OdaijinSamaX/wildlife-cam/hardware/enclosure/README.md

# enclosure-lab

屋外 IoT の防水筐体を **AI が設計して 3D プリントする** ための作業台。

AI が CAD を扱うときの本質的な弱点は「目が無い」ことにある。だからこのリポジトリの
本体は CadQuery のラッパではなく、**書いた形を自動で見て・測って・数字で突き返す
ループ**である。

```
設計スクリプト (CadQuery)
   -> build   : STEP / STL / 3MF
   -> render  : 6 面 + iso + 断面 PNG（人と AI が目で見る用）
   -> checks  : 肉厚・密閉・干渉・サイズ枠・オーバーハング・開口を数値で判定
   -> report  : out/<design>/report.md に画像と数値と PASS/FAIL
```

最初の利用先は wildlife-cam（Pi Zero 2 W のトレイルカメラ）。プリンタは
**Bambu Lab P1S**（密閉筐体・ASA 可）、造形枠 256 x 256 x 256 mm。

## 1 行で試す

```bash
uv run python -m harness check designs/wildlife_cam/fit_coupon.py
```

`out/fit_coupon/` に STEP / STL / 3MF と PNG 9 枚と `report.md` が出る。

```bash
uv run python -m harness check designs/wildlife_cam/pir_bezel.py
uv run python -m harness list                 # 設計とチェックの一覧
uv run pytest                                 # ネガティブテスト（下記）
```

主なオプション:

| オプション | 意味 |
|---|---|
| `--only wall,openings` | 一部のチェックだけ走らせる |
| `--no-render` | PNG を作らない（速い） |
| `--no-export` | STEP/STL/3MF を作らない |
| `--pitch 0.4` | openings のボクセルピッチを上書き |
| `--out DIR` | 出力先を変える |

終了コードは総合判定が FAIL のとき 1、それ以外 0。CI に直接掛けられる。

## 環境構築

```bash
curl -LsSf https://astral.sh/uv/install.sh | sh   # uv が無ければ
uv sync                                            # .venv を作って依存を入れる
```

`sudo` も apt も要らない。すべて PyPI の wheel で完結する。

### なぜ Python 3.12 なのか

母艦のシステム Python は 3.14 だが、**CadQuery / OCP には 3.14 用の wheel が無い**。
`.python-version` で 3.12 に固定し、`uv` がプロジェクト専用の Python を持ってくる。
システム Python には一切触らない。実績のある組み合わせは:

| | バージョン | 備考 |
|---|---|---|
| Python | 3.12.13 | uv が管理。3.14 では OCP が入らない |
| cadquery | 2.8.0 | |
| cadquery-ocp | 7.9.3.1.1 | OCCT 7.9 |
| vtk | 9.6.2 | レンダに使う |
| trimesh | 5.0.0 | メッシュ側のチェックに使う |
| shapely | 2.1.2 | 断面ラスタライズと張り出し幅の計算 |

### ヘッドレスレンダについて

GUI が無いのでオフスクリーン描画が要る。実際に試した結果:

- **採用: VTK のオフスクリーン (EGL)** — `vtkRenderWindow.SetOffScreenRendering(1)`
  だけで PNG が出た。VTK は X への接続に失敗したあと EGL に落ちる
  （`bad X server connection. DISPLAY=` という警告が出るが無害）。
  apt パッケージも仮想ディスプレイも要らない。
- **予備: numpy の Z バッファによるソフトウェアラスタライザ** —
  `harness/render.py` に同梱。EGL が使えない環境や GPU の無いコンテナ用。
  `ENCL_RENDERER=soft` で強制でき、VTK が例外を投げたときも自動で切り替わる。
- **却下: `xvfb-run`** — apt が必要（この母艦では sudo パスワードが要る）。
- **却下: pyrender / OSMesa ホイール** — 依存が重く、VTK で足りたので採用しなかった。

レンダが真っ白/真っ黒になった場合は VTK 側の失敗とみなして自動でソフトウェアに
落ちる。どちらを使ったかは `report.md` の先頭に出る。

## リポジトリの中身

```
harness/           ハーネス本体
  cli.py           `python -m harness check <design.py>`
  design.py        設計スクリプトの読み込みと派生データのキャッシュ
  geom.py          B-rep <-> メッシュ <-> ボクセルの変換（OCC / trimesh / shapely はここだけ）
  build.py         STEP / STL / 3MF 出力
  render.py        多視点 + 断面 PNG（VTK / ソフトウェア）
  report.py        Markdown レポート
  component.py     内蔵部品を表す型
  feature.py       フィーチャの占有領域 (claim) を表す型と、その作り方
  fit.py           寸法補正テーブル（実測から起こした造形の癖の吸収）
  seal.py          パッキンの面圧（蓋を梁・パッキンを非線形の弾性床として解く）
  captive.py       捕捉式ねじが成立するための寸法の連鎖
  underside.py     基板の下に出ている実装部品と受け面の隙間
  checks/          13 のチェック（下記）
parts/             内蔵部品のダミー形状（BOM プリミティブ）
designs/           設計スクリプト
tests/             ネガティブテスト
out/               生成物（.gitignore 済み）
docs/AGENTS.md     AI が設計を書くときの規約
docs/HARNESS.md    各チェックの意味・閾値の根拠
docs/DECISIONS.md  設計判断の記録（不採用にした案も残す）
docs/layout-study.md  wildlife-cam 内部レイアウトの比較検討（4 案 + 推奨）
docs/window-options.md  カメラ窓の方式と材料の比較
docs/field-procedure.md 現地作業手順の下書き
docs/enclosure-body.md  カメラユニット本体の設計判断（貫通・締結・分割の是非）・限界
docs/lid-fastening.md   蓋の締結点の数と位置。パッキンの面圧をたわみから解いた記録
docs/captive-fasteners.md  蝶ねじを蓋に残す（落としたら二度と見つからない）
docs/pcb-tray.md        基板トレー。CSI レスキューを付けた Pi と x の収支 0.4 mm
```

## チェック

| # | 名前 | 見るもの |
|---|---|---|
| 0 | fit | 寸法補正テーブルの素性と、どの寸法にいくら足したかの記録 |
| 1 | manifold | 水密・多様体か（B-rep とメッシュの両方） |
| 2 | wall | 最小肉厚（レイキャスト法）。薄い箇所は座標も出す |
| 3 | bbox | 造形姿勢を適用したあと P1S の枠に収まるか |
| 4 | interference | ソリッド同士のブーリアン積の体積が 0 か |
| 5 | layout | **同じソリッドの中で**フィーチャ同士が場所を奪い合っていないか |
| 6 | clearance | 内蔵部品の外形 + クリアランスが筐体と干渉しないか |
| 7 | overhang | 造形姿勢を適用したあとの下向き面の面積と渡り幅 |
| 8 | openings | 内外を貫通する開口の一覧と面積（防水の要） |
| 9 | fov | カメラの視野を筐体が遮っていないか |
| 10 | seal | 締結点の間でパッキンの潰し量が保つか（蓋を梁、パッキンを弾性床として解く） |
| 11 | captive | 捕捉式ねじが「落ちない・抜けきる・平らに座る」か（形にレイを飛ばして実測） |
| 12 | underside | 基板の**下**に出ている実装部品が受け面に当たらないか（同じく形から実測） |

**すべてのチェックは PASS/FAIL だけでなく実測値を返す。**
閾値の根拠と「何を見逃すか」は `docs/HARNESS.md` にある。

## ネガティブテストという約束

このリポジトリの最大の失敗モードは **「チェックが常に PASS を返すだけの飾りに
なること」**。それを防ぐため、各チェックには「意図的に壊した設計を食わせると
FAIL する」テストが付いている。

```bash
uv run pytest -q
```

- 肉厚を 0.8 mm に落とした変種 → `wall` が FAIL
- 部品を壁にめり込ませた変種 → `clearance` が FAIL
- 300 mm に伸ばした変種 → `bbox` が FAIL
- 止まり穴を貫通させた変種 → `openings` がその穴を検出して FAIL
- 造形姿勢を 90 度倒した変種 → `overhang` が FAIL
- O リング溝を基準ピンの根元に重ねた変種 → `layout` が FAIL（実際に出た不具合の再現）
- 取付ねじをシール溝に寄せた変種 → `layout` が FAIL
- 穴の宣言を 1 つ落とした変種 → `layout` が「宣言し忘れ」として FAIL
- 蓋の締結点を四隅 4 点に戻した変種 → `seal` が FAIL（実際に出た指摘の再現）
- トレーの座面を縮めた変種 → `underside` が FAIL（基板の裏のナットが当たる）

**ネガティブテストが無いチェックは未完成とみなす。**

## いまある設計

| 設計 | 何のためか |
|---|---|
| `designs/wildlife_cam/fit_coupon.py` | 公差校正クーポン v1。**2026-08-22 に印刷して実測済み**の実物の記録（凍結） |
| `designs/wildlife_cam/fit_coupon_v2.py` | 同 v2。補正テーブルを通し、基準ピンを折り取り式の独立部品にした。実測値と導出は [fit_coupon.md](designs/wildlife_cam/fit_coupon.md) |
| `designs/wildlife_cam/pir_bezel.py` | HC-SR501 を筐体壁に防水で貫通させる接着封止キャリア |
| `designs/wildlife_cam/layout_study_{a,b,c,d}.py` | 内部レイアウトの比較検討 4 案。結論は [layout-study.md](docs/layout-study.md) |
| `designs/wildlife_cam/camera_unit.py` | **カメラユニット本体（実設計）**。案D を起こしたもの |
| `designs/wildlife_cam/camera_unit_lid.py` | 同 背面の蓋。鞍（V 溝）とベルト溝つき |
| `designs/wildlife_cam/window_snoot.py` | カメラ窓（主案）。既製ドーム蓋 + カメラ送り出し筒 |
| `designs/wildlife_cam/window_hood.py` | カメラ窓（代替案）。平板 + 庇 |

どちらも **まだ印刷していない**。

`pir_bezel.py` は名前こそベゼルだが、中身は**接着封止キャリア**である。
HC-SR501 の実測（2026-08-22）でドームにツバが無いことが判明し、
「フランジを O リングで壁に押し付ける」旧構成が不成立になったため作り直した。
検討して不採用にした案を含む経緯は [docs/DECISIONS.md](docs/DECISIONS.md) にある。

筐体本体の設計に入る前に、`docs/AGENTS.md` の「内蔵部品の寸法順位」を見ること。
最長の部品は SORACOM Onyx（USB ドングル・95 mm）で、筐体の内寸はこれで決まる。
