OdaijinSamaX/wildlife-cam/hardware/enclosure/.ai/HANDOFF.md

# HANDOFF — 筐体設計（`hardware/enclosure/`）

- 最終更新: 2026-08-23（**レスキュー装着後の Pi に合わせて箱ごと引き直した**）
- **この文書は、会話の記憶が無いエージェントが最初に読むもの。**

---

## 0. 読む順序

1. **`docs/AGENTS.md`** — このリポジトリで設計するときの規約。
   とくに §3.5（寸法補正テーブル）・§4.5（フィーチャの占有領域）・
   **§4.9（現地で保守する人のための設計原則）** は全設計に効く。
2. **`docs/DECISIONS.md`** — これまでの決定事項（D-001 〜 **D-023**）。
   **不採用にした案も理由つきで残してある。** 同じ検討を二度やらないため。
3. **`docs/HARNESS.md`** — チェック **13 種**の意味・閾値の根拠・**何を見逃すか**。
4. 個別の経緯が要るときだけ:
   `docs/layout-study.md` / `docs/window-options.md` / `docs/enclosure-body.md` /
   `docs/lid-fastening.md` / `docs/captive-fasteners.md` /
   **`docs/pcb-tray.md`（基板トレー。x の収支が 0.4 mm しか無い理由）** /
   `docs/field-procedure.md`
5. **各設計ファイルの docstring。** 何のための部品か・未確定事項が先頭に書いてある。

---

## 1. どこまで到達したか

**2026-08-23 に「レスキュー装着後の Pi の実測」が入り、箱の外形から引き直した。**
全チェック PASS/WARN（FAIL・ERROR なし）、テスト 210 件通過。

| 設計 | 状態 |
|---|---|
| `camera_unit.py` | **本体。外形 84 -> 88（D-022）。** トレーの受けも作り直した（D-023） |
| `camera_unit_lid.py` | **背面の蓋。** パッキン経路を本体から導出。**`seal` は 21.0% -> 21.2%** |
| **`pcb_tray.py`** | **全面書き直し。** レスキュー装着後の Pi を 2 本 + ナットポケットで保持 |
| `window_snoot.py` | カメラ窓（主案）。**ドームの 7 項目が未実測なので刷れない** |
| `window_hood.py` | カメラ窓（代替）。平板 + 庇 |
| `pir_bezel.py` | PIR 接着封止キャリア |
| `fit_coupon.py` / `_v2.py` | 公差校正クーポン（v1 は印刷実物の記録として凍結） |
| `layout_study_{a,b,c,d}.py` | レイアウト比較検討。**採用は案D** |

外形は **88 x 50 x 198 mm**（造形時の Z は 50 mm。§6 の注意を読むこと）。

### 2026-08-23: 箱を 84 -> 88 にした（D-022）

Pi には **CSI コネクタのラッチが壊れた個体を救うためのレスキューブラケット**
（双葉数理技術「Camera Connector Rescue」）が付いている。**Pi の外形そのものが変わる。**

**束縛していたのは「内寸 78.0」ではなく「背面の開口 74.0」だった。**
microSD を挿したままの剛体幅は **76.9 mm**（4.1 + 65.0 + 7.8。全部実測）で、
**開口 74.0 に 2.9 mm 足りない。** `rim_step` を下限 1.35 まで削っても 1.6 mm 足りず、
**幅を増やすしかなかった。** 増やした片側 2 mm は全部内側へ回してある。

**`seal` の最小圧縮率は 21.0% -> 21.2% で、落ちていない**（蓋が広くなって
断面二次モーメントが増えたぶんが、パッキン経路が伸びたぶんを上回った）。
D-019（締結 6 点）の結論は維持される。

### 2026-08-23: トレーを作り直した（D-023）

- **ブラケットが CSI 側の取付穴 2 個をねじ + ナットで占有**していた（写真で確認）。
  **共締めは不成立。** microSD 側の 2 本 + **ナットポケット 2 個**で保持する
- **+Z の押さえを天井から吊った。** x の予算（片側 0.4 mm）が無いので、
  側壁から内側へは出せない。副産物として**受けの z が柱に縛られなくなった**
- **ポカヨケをフックの段（0.8 mm）と取っ手に分けた。** 対照実験で
  「段が効くのは前後反転だけ / 上下系は取っ手が単独で止めている」と分かった

### 2026-08-23: 13 個目のチェック `underside` を足した

**12 種のどれも「実装部品が基板の下に出ている」ことを捕まえなかった。**
`clearance` は「座面には envelope を太らせない」規約（AGENTS.md §4）のせいで、
基板の下にぶら下がっているものを**意図した接触として飲み込む**。
`UNDER_BOARD` を宣言すると、**`build()` にレイを格子状に飛ばして**隙間を実測する。
**ネガティブテスト 3 本**（うち 1 本は実装当初のバグの回帰テスト）。
詳細は `docs/HARNESS.md` の 12。

---

## 2. ★ 刷る順番（**人間が「実際に作る」フェーズに入った**）

**大原則: 「刷らないと分からないこと」と「刷る前に決めないといけないこと」を分ける。**
後者を残したまま大物を刷ると、**刷り直しが一番高くつく。**

### 2.0 刷る前に片付けること（**卓の上で終わる。プリンタは要らない**）

| # | 何 | なぜ先か | 効く先 |
|---|---|---|---|
| **A** | **FFC を実際に曲げて、バーの先端から何 mm 出るか測る** | **本体の幅が変わりうる**（`docs/pcb-tray.md` §6-1）。半径 3.0 を取ると側壁を 0.75 mm 超える | **`camera_unit` の `width`** |
| **B** | **ナットの二面幅（`NUT_AF`、推定 5.0）をノギスで測る** | トレーのポケット φ6.6 が決まる | `pcb_tray` |
| **C** | **M3 ヒートセットインサートの外径を実測**（2026-08-24 到着予定） | `parts/m3_heatset.PILOT_DIA`（推定 4.2）が決まる | **その部品を使う全設計** |
| **D** | **捕捉リテーナの型番と外径 / 厚み**（E 形止め輪 呼び4/5 か押しナット） | 蓋の捕捉ポケット径が決まる。**刷ってからでは直せない** | `camera_unit_lid` |
| **E** | **蝶ボルト M4/M5 x 30 の頭の径と高さ** | 座ぐり φ9.0 x 深さ 3.0 に収まるか | 同上 |

**A が一番重い。** これが「幅 89.5」に転ぶと本体も蓋もトレーも引き直しになるので、
**本体を刷る前に必ず決めること。**

### 2.1 刷る順番

| 順 | 何を | なぜその順か | 大きさ |
|---|---|---|---|
| **1** | **`fit_coupon_v2`** | **他に何も依存しない。** いま補正テーブルは φ2.0〜5.0 が**暫定**・一部**外挿**で、**トレーの x の余裕は片側 0.4 mm しか無い**。補正が 0.2 ずれると入らない。**最初に刷って測る** | 小 |
| **2** | **`pcb_tray`** | **本体が無くても Pi を載せて確かめられる**（ねじ 2 本が入るか / ナットがポケットに落ちるか / 取っ手が手袋で掴めるか）。小さいので刷り直しが安い。**B が済んでいること** | 小 |
| **3** | **`pir_bezel`** | 寸法が実測で埋まっていて他に依存しない。C が済んでからにすると下穴も確定する | 小 |
| **4** | **`camera_unit`（本体）** | **A を決めてから。** 大物で時間がかかる。**刷らないと反りが測れない**ので、ここを越えないと反りの宿題が永久に片付かない | 大 |
| **5** | **`camera_unit_lid`（蓋）** | **反りの実測は本体と蓋の両方が要る**（定盤に当てて隙間を測る）。D / E が済んでいること | 大 |
| — | `window_snoot` | **刷れない。** ドーム嵌合部の 7 項目（`parts/dome_lid.UNMEASURED`）が未実測 | — |

### 2.2 「刷れば解ける」 / 「刷る前に決める」

**刷れば解ける**（刷るまで手の打ちようが無い。だから 4 と 5 を早く越える）:

- **合わせ面の反り**（計算した弾性変形 0.08 mm より大きくなりうる。**最大の未知数**）
- クリック止めの保持力（歯 0.4 mm x 45 度）
- **差し込みの感触**（片側 0.4 mm しか無い。反りが出ると入らなくなる）
- 取っ手が手袋で掴めるか / 蝶ねじが手袋で回せるか
- M2.5 タッピングの下穴 φ2.1（推定）
- 補正テーブルの暫定値・外挿（1 の `fit_coupon_v2` で潰す）

**刷る前に決める**（刷ってからでは直せない）:

- **A: FFC の曲げ**（本体の幅そのもの）
- **B: ナットの二面幅**（トレーのポケット径）
- **C: インサートの外径**（全設計の下穴）
- **D / E: リテーナと蝶ボルト**（蓋の捕捉ポケットと座ぐり）
- ドームの 7 項目（`window_snoot` を刷る前）

---

## 3. 未設計 / 残っている宿題

1. **Onyx の保持。** z 21〜136 に寝ているが**何にも留まっていない**。
   **D-023 で「天井から吊る」という手が使えるようになった**ので、
   `pcb_tray` の受けと同じ考え方が横展開できるはず
2. **合わせ面の段差**（締め忘れ・異物の噛み込みが目で見て分かるように）
3. **蓋のキー溝**（ポカヨケ。いまは M5 の 1 本と中央の対の非対称で効いている）
4. **前面リブの本数**（たわみ計算をしていない。縦 2 本は目安）
5. **合わせ面の反りの実測**（§2。刷らないと始まらない）
6. **ドーム嵌合部の 7 項目**（`parts/dome_lid.UNMEASURED`）
7. **通気つきグランドの入手性確認**（貫通が 4 -> 3 に減る）
8. 刻印の内容の追加（開ける向き・「2 周締める」・「開口を上に向けない」）
9. **OTG ケーブルの結束点**（トレーを引き出すときに突っ張らないこと）
10. **`RESCUE_Y_POS` の再測定**（`parts/pi_zero_2w_rescue`）。
    **いまの形には効かない**（ポカヨケのためにあえて使っていない）が、
    バーの逃げを作る日が来たら要る

---

## 4. 人間への確認事項（**実装は止めずに推定で進めてある**）

§2.0 の A〜E がそのままこの表である。加えて:

| # | 何を確かめるか | どこに効くか |
|---|---|---|
| 6 | **トレーのガタ。** 上のフックまでの遊びは 0.6 mm。風で揺れ続ける設置先なので、音が出るならスポンジ 1 枚 | `camera_unit.PARAMS["tray_lift"]` |
| 7 | **幅 88 の受風面積 +4.8% を許容するか**（D-022 で受け入れ済み。設置してみて揺れるようなら再考） | `camera_unit.PARAMS["width"]` |
| 8 | **`RESCUE_SCREW_HEAD` の解釈。** 実測 0.5 は「ねじ頭がブラケット上面から出る量」で、定数の定義（基板上面から）と基準面が違う | `parts/pi_zero_2w_rescue` |

---

## 5. 外部から来る予定の情報

| # | 何 | いつ | 来たらやること |
|---|---|---|---|
| 1 | **M3 ヒートセットインサート** | **2026-08-24 到着予定** | 外径を実測し、`fit_coupon`（印刷済み）の下穴 3 種の結果と突き合わせる。`parts/m3_heatset.PILOT_DIA` と `DIM_SOURCE` を更新。**その部品を使う全設計を回し直す** |
| 2 | **合わせ面の反りの実測** | 実機ができたら | `docs/lid-fastening.md` §6。**計算より効く可能性がある** |
| 3 | **ドーム蓋の嵌合部 7 項目** | 未定 | `parts/dome_lid.UNMEASURED` を埋める。`window_snoot.py` のリブ寸法が変わる |
| 4 | **レスキューブラケット** | **到着済み。2026-08-23 に実測が入り `parts/pi_zero_2w_rescue.py` に反映済み** | 残るのは `RESCUE_Y_POS` と `NUT_AF` |
| 5 | **通気機能つきケーブルグランド** | 入手性を確認する | 手に入れば**貫通が 4 -> 3 に減る**。底面の 2 穴を 1 つに統合する |

---

## 6. 造形姿勢と「高さ 229 mm」についての注意

**混乱しやすいので明記する。**

```
PRINT_ORIENTATION = {"rotate": (90, 0, 0)}   背面の開口を上に向けて刷る
設計座標   X 88.0  Y 50.0  Z 198.0
造形姿勢後 X 88.0  Y 198.0 **Z 50.0**
```

**造形時の Z は箱の「奥行き」= 50 mm。** 設計上の高さ 198 mm は造形時には
XY 平面に寝るので、効く上限は**ベッドの 256 mm** の方である。
閉じた箱は天井ができて刷れないため、この姿勢に選択の余地はない。

「高さ 229 mm がハードな上限」という話は**設計上の高さ**についてのもので、
造形 Z の上限ではない。詳細は `docs/enclosure-body.md` §1 と D-014。

---

## 7. 動かし方

```bash
cd hardware/enclosure
uv sync
```

`sudo` も apt も不要。uv が Python 3.12 を取ってくる（システムの 3.14 は触らない）。

```bash
uv run python -m harness list
uv run python -m harness check designs/wildlife_cam/pcb_tray.py
uv run pytest -q
```

`out/` は生成物なので Git に入っていない。作り直すには:

```bash
for d in fit_coupon fit_coupon_v2 pir_bezel window_hood window_snoot \
         layout_study_a layout_study_b layout_study_c layout_study_d \
         camera_unit camera_unit_lid pcb_tray; do
  uv run python -m harness check designs/wildlife_cam/$d.py
done
```

**期待する結果**（2026-08-23 時点の実測。`FAIL` と `ERROR` は 1 件も出ない）:

- `out/<design>/` に STEP / STL / 3MF と PNG 9 枚と `report.md`
- `pytest`: **210 passed**（約 12 分半）
- `fit_coupon` だけ総合 **PASS**。**他の 11 設計は総合 WARN** で、その内訳は
  `overhang`（下向き面。いずれも span 10 mm 以下でブリッジ可）と
  `fit`（補正テーブルに暫定値・外挿が混じっていることの申告）だけ
- `pcb_tray` の `underside` は **PASS**（基板の下の突起 3 個すべてが受け面に当たらない）

---

## 8. Known risks / likely failures

1. **レンダ**: VTK の EGL オフスクリーンに依存している。GPU が見えない環境では
   例外になり、ソフトウェアラスタライザに自動で落ちる（`ENCL_RENDERER=soft` で強制可）。
   落ちたことは `report.md` の「注意」に出る。落ちても数値チェックには影響しない。
2. **起動時の警告**: `bad X server connection. DISPLAY=` が毎回出る。VTK が X を
   試して失敗し EGL に切り替える際のもので、無害。
3. **実行時間**: `check` 1 本が 20〜35 秒（テッセレーション + レイキャスト +
   ボクセル化）。`pytest` は約 12 分半。
4. **openings のボクセルピッチ**: 既定 0.5〜0.8 mm。細かくすると重くなる。
   `--pitch` で上書きできる。
5. **`cq.Face.positionAt(0.5, 0.5)` はトリムされた面の外に出ることがある**
   （実測で板の外の z が返った）。円筒面上の代表点が要るときは
   `geom.CylFace.probe_point()` を使う。
6. **`cq.Workplane.revolve` の軸はローカル座標系**。`"XZ"` ワークプレーンで
   グローバル Z 軸まわりに回すには `(0,1,0)` を渡す。ここを間違えると体積 0 の
   板ができる（manifold チェックが検出する）。

---

## 9. Hardware or credential gaps

- 3D プリンタ（P1S）での **実印刷は未実施**。
- **HC-SR501 は実測済み** (`measured:2026-08-22`)。ただし HOLE_DIA 2.2 と
  HOLE_PITCH 28.5 は誤差の可能性ありと申告されている（この設計は取付穴を
  使っていないので影響しない）。
- **OTG ケーブルは実測済み** (`measured:2026-08-22`)。
- IR 投光器は **実測が未実施** (`DIM_SOURCE = "estimated"`)。
- `parts/soracom_onyx.py` は外形 95x36x13 / 36g がメーカー公称 (`DIM_SOURCE = "datasheet"`)
  だが、**USB プラグ突出量・SIM スロット位置・CRC9 端子位置は推定**で、実測待ち。
  CRC9 がどちらの長辺かも不明なため、envelope は両側に逃げを取る保守的な形にしてある。
- **筐体内で最長の部品は SORACOM Onyx の 95 mm**（Pi Zero 2 W の 65 mm より長い）。
  抜き差し代を含めると 110 mm 前後の直線的な空きが要る。詳細は docs/AGENTS.md。
- スライサ連携（印刷時間・材料量の見積り）は次フェーズ。

---

## 10. PIR の封止方式（読まずに触らないこと）

`designs/wildlife_cam/pir_bezel.py` は名前こそベゼルだが、中身は
**接着封止キャリア**である。HC-SR501 の実測でドームに **O リングを座らせる
ツバが無い**ことが判明し（FLANGE_DIA == DOME_DIA == 23.0）、旧構成が
不成立になったため作り直した。

- 採用: 案B 接着封止（ボンドライン片側 0.30 mm / 接着代 3.3 mm / 口元に溜まり）
  + フェイス O リング（φ2.0 / 中心径 34.0）
- 不採用: 案A ラジアルシール（軸方向予算がちょうど 0、圧縮率が造形誤差で
  10〜40% に振れる、はみ出し隙間が過大）
- 不成立: 基板を使った面シール（片側 0.70 mm しか残らない）

根拠と数字は `docs/DECISIONS.md` の D-001。**造形姿勢は宣言であり、
内径の軸を造形方向に平行に保つこと**（`tests/test_checks_negative.py` が検証する）。

残リスク: フレネルドームが HDPE 系だとシリコーンは化学的に接着しない。
機械的な保持（溜まり + 狭隙間へのくさび効果）で成立させる設計にしてあるが、
実物で剥離試験をすること。

---

## 11. 配線レイアウトの制約

Pi Zero 2 W 65 + OTG ケーブル 150 + Onyx 95 = **310 mm** で P1S の枠 256 mm を
超える。**折り返し配置が必須。** 折り返せるのはケーブルの可動部 84.2 mm だけで、
両端のコネクタ 65.8 mm は剛体。詳細は `docs/AGENTS.md` と D-003。

---

## 12. 忘れてはいけない設計前提（詳細は DECISIONS.md）

- **現地で保守するのは機械に強くない人。** 設計者本人ではない（D-015）
- 設置先は **屋久島の直径 48〜64 mm の細い木**（D-016）
- **バッテリーは筐体の外**（D-017）
- **microSD は現地で抜かない**（D-018）。**だから幅 76.9 で設計している**（D-022）
- 補正テーブルは **ASA / P1S / 0.4 mm ノズル / 平置き** の組にしか意味がない（D-004）
- **ネガティブテストが無いチェックは未完成**（README / AGENTS.md）
- **パッキンを潰す合わせ面は `SEAL_SPANS` を宣言して `seal` チェックを通す**（D-019）
- **現地で外すねじは `CAPTIVE_SCREWS` を宣言して `captive` チェックを通す**（D-020）
- **基板を載せる設計は `UNDER_BOARD` を宣言して `underside` チェックを通す**（D-023）
- **蓋の柱 6 点は内部レイアウトを強く縛る**（D-021）。ただし
  **天井から吊れば柱の間を使える**（D-023）
- **x の余裕は片側 0.4 mm しか無い**（D-022 / D-023）。**内部に何かを足すときは
  必ず `docs/pcb-tray.md` §2 の収支を見ること**

---

## 13. Smallest acceptable fix policy

- チェックの閾値を緩めて PASS にするのは禁止。形を直すか、設計の docstring に
  理由を書いて `CHECK_CONFIG` で明示的に上書きする。
- 新しい失敗を潰したら `tests/test_checks_negative.py` にその失敗を再現する
  ケースを足す。ネガティブテストの無いチェックは未完成とみなす。
- `parts/` の推定寸法を触るときは `DIM_SOURCE` を必ず更新し、その部品を使う
  全設計で `harness check` を回し直す。

---

## 14. レスキュー基板の測定・複製資料について

**意図的に除外している**（購入品につき個人利用の範囲に留める）。
このリポジトリに入っているのは**装着後の外形寸法だけ**で、それが幅 84 -> 88 の
根拠になっている（`parts/pi_zero_2w_rescue.py`）。
**移植漏れではないので、戻さないこと。**
