OdaijinSamaX/wildlife-cam/hardware/enclosure/docs/enclosure-body.md

# カメラユニット本体 — 設計判断

- 日付: 2026-08-23
- 実装: `designs/wildlife_cam/camera_unit.py`（本体）/ `camera_unit_lid.py`（蓋）
- 前提: `docs/layout-study.md` §5（案D 採用）/ `docs/AGENTS.md` §4.9（現地 UX 原則）

---

## 1. 高さ 229 mm の制約について（**まず確認が要る**）

指示は「造形時の Z が 229 を超えないこと」だった。実際に測ると:

```
PRINT_ORIENTATION = {"rotate": (90, 0, 0)}   背面の開口を上に向けて刷る

設計座標   X 88.0   Y 50.0   Z 198.0     （**幅は 84 -> 88 に改訂。D-022**）
造形姿勢後 X 88.0   Y 198.0  **Z 50.0**
```

**背面の開口を上にして刷るので、造形時の Z は箱の「奥行き」= 50 mm になる。**
設計上の高さ 198 mm は造形時には XY 平面に寝るので、効く上限は**ベッドの
256 mm** の方である。案D の 229 mm も同じで、`layout_study_d` を
`harness check` に掛けると造形姿勢適用後の Z は 31.7 mm と出る。

閉じた箱は天井ができて刷れないので、この姿勢は選択の余地がない
（本体は開口を上、蓋は平板として別に刷る）。したがって **229 mm は造形の
上限としては効いていない。**

**それでも高さは 229 -> 198 mm に減らした。** 理由は造形ではなく取り付け:

| | 案D 検討時 | 本設計 |
|---|---|---|
| 高さ | 229 mm | **198 mm** |
| 受風面積 | 192 cm2 | **166 cm2**（-13%） |
| 鞍の接触長 | 229 mm | 198 mm |

受風面積が減り、材料と質量も減る。接触長は 31 mm 短くなるが、ベルト 2 本の
支点間距離は **114.8 mm**（z = 49.5 と 164.3）あり十分である。
**余裕は安全のためにある**（指示のとおり）。

> ベルトの z は蝶ねじの位置で決まっている。**ベルトの下に来た蝶ねじは現地で
> 回せない**ので、座ぐりを避けた窓に置いてある（D-019 / `docs/lid-fastening.md` §8.1）。

---

## 2. 幅を 77 -> 84 mm に増やした。その代償

**ドーム蓋の口径 76.0 mm が幅を決めた。** 案D の 77 mm には嵌合リブ
（外径 79.4 = 75.4 + 肉 2.0 x 2）が入らない。

| | 案D 検討時 | 本設計 | 差 |
|---|---|---|---|
| 幅 | 77.0 mm | **84.0 mm** | +7.0 |

> **2026-08-23 改訂: 幅は 88.0 mm になった（D-022）。** CSI レスキューを付けた Pi が
> 背面の開口を通らなかったため。張り出しは片側 20.0 mm、受風面積 +4.8%。
> 下の数字は D-014 時点のもの。
| **幹（直径 48）からの張り出し 片側** | 14.5 mm | **18.0 mm** | **+3.5（+24%）** |
| 受風面積 | 176 cm2 | 166 cm2 | **-6%**（高さを減らしたぶん） |

**張り出しは 3.5 mm 増えたが、受風面積は差し引きで減っている。**
これ以上幅を詰めるには、ドームを口径の小さい別の既製品に変えるしかない。
`camera_unit.overhang_from_trunk_mm()` が数値を返す（テストで固定）。

**優先順位（指示のとおり）の結果:**

1. 高さを超えない -> 198 mm（造形 Z は 50 mm）✓
2. 張り出しを増やさない -> +3.5 mm。**ドームの口径で決まる下限**
3. 体積 -> 88 x 50 x 198 = 871 cm3（蓋とドームを除く。**幅は D-022 で 88**）

---

## 3. 貫通は 4 つ。3 つに減らせるか

| # | 貫通 | 径 | 面 | 封止 |
|---|---|---|---|---|
| 1 | PIR | φ26.0 | 前面 | `pir_bezel` のラジアル O リング |
| 2 | カメラ FPC ポート | φ8.0 | 前面 | シーラント（2 段目の密閉境界） |
| 3 | ケーブルグランド | φ12.6 | **底面** | グランド本体 |
| 4 | 通気ベント | φ12.3 | **底面** | ベント本体 |

グランドとベントを**底面**に置いたのは、水が溜まらず、電源ケーブルが自然に
垂れるため。上面や側面に置くと水が滞留する。

### 3.1 電源ケーブルとグランドの選定

**ケーブル外径 2.8 mm を自己融着テープで 5 mm 前後に増径して通す。**

PG7 の把持範囲は **3.0 〜 6.5 mm**（`parts/cable_gland.py`。推定値）。

| 案 | 把持範囲 | 2.8 mm 素のまま | テープで 5 mm | 評価 |
|---|---|---|---|---|
| **PG7** | 3.0〜6.5 | **下限ぎりぎり** | **5.0 は範囲の中央** | **本命** |
| PG9 | 4.0〜8.0 | 不可 | 5.0 は下寄り | 穴が大きくなるだけ |
| M12x1.5 | 3.0〜6.5 | 同上 | 同上 | PG7 と同等。入手性で選ぶ |

**PG7 + テープ増径を採る。** 理由:

- 素の 2.8 mm は下限 3.0 を**下回っており、そのままでは締まらない**。
  増径は必須であって、あってもなくてもよい工夫ではない。
- 増径後 5.0 mm は 3.0〜6.5 の**ほぼ中央**で、締め代が最も安定する。
- 穴が φ12.6 で済む（PG9 なら φ15.5 前後になり、貫通が大きくなる）。

**運用上の注意（現地手順に入れること）:**

- テープは**グランドの把持部の全長 + 前後 5 mm** に巻く。局所的に巻くと
  グランドの中でケーブルが動き、シールが効かない。
- 自己融着テープは経年で流れる。**巡回のたびに増径部を触って確認する。**
- 増径部の外径は**測ってから**巻き終える（目分量だと 6.5 を超えることがある）。

### 3.2 通気機能つきグランドで 3 つに減らせるか

**減らせる。ただし入手性が未確認。**

通気膜（ePTFE）を内蔵したケーブルグランドが市販されており、これを使えば
**貫通 3 と 4 が 1 つになり、合計 3 つになる。** 貫通は漏水の第一原因なので、
**1 つ減るのは大きい。**

| | 分離（現状） | 通気つきグランド |
|---|---|---|
| 貫通の数 | 4 | **3** |
| 部品点数 | 2 | **1** |
| 入手性 | **確実**（PG7 と M12 ベントは一般品） | **未確認**（PG7 サイズで通気つきがあるか） |
| 通気面積 | ベント単体のぶん確保できる | 小さくなる可能性 |
| 交換 | 別々に交換できる | 片方が壊れると両方交換 |

**判断: いまは分離のまま設計し、通気つきグランドが入手できたら差し替える。**
底面の 2 穴は 44 mm 離してあるので、1 穴に統合するのは形状変更だけで済む
（`gland_x` / `vent_x` を触るだけ）。**入手性を先に確認すること。**

---

## 4. 蓋の締結方式

**前提: 防水にはパッキンを潰す力が要る。締結力は弱くできない**
（`docs/AGENTS.md` §4.9.2）。

O リング φ2.0 を 25% 潰すのに必要な線圧は **1.86 N/mm**
（70 Shore A。Gent + Lindley の式から。`harness/seal.py`）。
この蓋のパッキン周長は **540 mm**（レーストラック 2x192 + 2x78）なので、
**合計およそ 1.0 kN**、6 点で受けて **ねじ 1 本あたり 185 N** である。

> **2026-08-23 訂正。** ここには当初「線圧 3〜5 N/mm / 周長 760 mm / 合計 2.3〜3.8 kN」と
> 書いてあったが、線圧は出所が無く、周長も実際の溝と合っていなかった。
> 導出は `docs/lid-fastening.md` §1.2 と §3。**桁は変わらないので方式の選定
> （爪では足りない・ラッチは幅が増える・蝶ねじが本命）は影響を受けない。**

| 方式 | 1 点の締結力 | 工具 | 捕捉 | ポカヨケ | 評価 |
|---|---|---|---|---|---|
| 印刷したスナップ爪 | 数十 N | 不要 | 一体 | 形状で可 | **不足。桁が足りない** |
| トグルラッチ（市販） | 300〜800 N | **不要** | 本体に固定 | 形状で可 | 力は足りるが**側面に付ける必要があり、幅が増える** |
| **蝶ねじ M4/M5** | **1 kN 以上** | **不要** | E リング等で可 | 径違いで可 | **本命**（要るのは 185 N） |
| 通常のねじ | 同上 | **要る** | しにくい | 位置で可 | 現地では最後の手段 |

**採用: 蝶ねじ 6 本（M4 x 5 + M5 x 1）。**
当初 4 本（四隅）だったが、**長辺中央でパッキンが浮く**ことが分かり、
中央に 1 対足して 6 本にした（**D-019 / `docs/lid-fastening.md`**）。

理由を効く順に。

1. **力が足りる。** スナップ爪は必要力に対して桁が足りない。ラッチは足りるが、
   この箱では**側面にしか付けられず、幅が増えて案D を選んだ理由を壊す**
   （張り出しが増える）。蝶ねじは内部の柱に締めるので幅に影響しない。
2. **工具が要らない。** 現地 UX 原則の本丸。
3. **ポカヨケが作れる。** 6 本のうち 1 本だけ M5 にしてある。180 度回すと
   M5 のねじが M4 のインサートに入らないので、**逆向きでは締まらない。**
   穴径の違いは目でも分かる。さらに**中央の対が上下非対称（z=142 だけ）**なので、
   逆向きでは穴の位置自体が合わない。
4. **数が少なく大きい。** 12 本の M3 より 6 本の M4/M5 の方が手袋で扱いやすい。
   **ただし 6 本は原則 2「数を減らして大きく」とは逆行している。**
   面圧（防水）を優先した結果であり、そのトレードは D-019 に書いた。

**柱は前壁から背面の合わせ面まで通してある。** 浮かないし、箱のねじれ剛性にも効く。
柱の位置 x = ±31 は、蓋の座ぐり（φ9〜10.5）が**パッキン溝（x 37.65〜40.35）から
2 mm 以上離れる**ように決めた。近すぎると溝を破って漏れ経路になる。

z 方向は **12 / 142 / 186** の 3 段。中央が 142（真ん中の 99 ではない）なのは、
**左側 (x=-31) で内蔵部品が空けている窓がそこしか無い**から
（Onyx が z 21〜136、Pi が z 148〜178）。詳細と代案は `docs/lid-fastening.md` §7。

**解決済み（2026-08-23）:** 面圧の均一性は `seal` チェックが毎回計算する。
四隅 4 点だと中央で圧縮率 13.3%（下限 15% 割れ）、6 点で 21.0%。
**補強リブや厚板では桁が足りない**（EI を 4.2 倍＝蓋を 14 mm 厚くする必要がある）
ことも数値で確認した。**残る未検証は合わせ面の反りとクリープ**（計算では出せない）。

---

## 5. スライド嵌合を使った箇所と、使えない箇所

`docs/AGENTS.md` §4.9.3 / §4.9.4 の線引きを、この設計に当てはめた結果。

| 箇所 | 方式 | 理由 |
|---|---|---|
| **基板トレー** | **スライド（アリ溝）** | 防水に関係しない。位置決めだけでよい |
| PIR キャリア | ねじ 4 本 + ラジアル O リング | **ピストン式の摺動シール**。挿し込みで半径方向に潰す |
| カメラポッド | ねじ 3 本 + フェイス O リング | 面圧が要る |
| ドーム | **既製品の嵌合** | 保持だけ。防水は下の O リングが受ける |
| **蓋** | **蝶ねじ 6 本** | **パッキンを潰す面圧が要る。スライドでは代替できない** |

**スライドで代替できない線引き**: パッキンを潰して防水する合わせ面。
面圧が要るので、位置決めしかできないスライドでは成立しない。

### 5.1 基板トレーの受け（**2026-08-23 に作り直した**）

**アリ溝は撤去した。** 蓋の締結 6 点（D-019）で立った柱が Pi の通り道を塞ぐので、
z 方向のスライドは成立しない。経緯と数字は `docs/pcb-tray.md` / **D-021**。

いまは **背面（開口側）から差し込む C チャンネル**（棚 + 位置決めリップ +
上の押さえ + 前の当たり）。トレー本体は `designs/wildlife_cam/pcb_tray.py`。

- **差し込み方向は設計上の Y**（造形方向と平行 = 段差を横切る）。
  原則から外れているので `SLIDE_AXIS_NOTE` に根拠を書いてある。
  **精度嵌合ではなく落とし込み**で、片側 0.5 mm の隙間を取ってある。
- **抜け止めはクリック止め。** 棚の天面の切り欠き（45 度 / 深さ 0.8）に
  トレーの歯が落ちる。**指で 0.8 mm 持ち上げれば外れる**（工具ゼロ）。
  「効いていること」と「外せること」の両方をテストで押さえてある。
- **ポカヨケ**: -X 側の棚だけ 2.5 mm 高い。逆向きでは物理的に座らない。
- アリ溝の隙間の校正（`fit_coupon_v2`）は、**この設計では使わなくなった。**
  ただし今後スライド嵌合を使う場面のために試験片は生きている。

---

## 6. リブ

前面（84 x 198）が最大の平面で、圧力差でたわむ。内面に**縦リブ 2 本**
（x = ±33、幅 2.4、高さ 5.0）を入れた。高さは増やしていない。

**未検証:** たわみ計算をしていない。2 本は目安であって、必要本数を出したわけでは
ない。実機で内外差圧（気温変化で数 kPa）を掛けたときの変位を見て決めること。

**蓋側にリブを足す案は D-019 で却下した。** 蓋の外面は鞍の V＝幹の当たり面なので
リブを置く場所が無く、V の外に足してもベルト溝がレールを削る量が増えて逆効果になる。
蓋は締結点を増やす方（たわみは支間の 4 乗で効く）で解いた。

---

## 7. 上下 2 分割の是非（判断材料）

**結論から言うと、一体造形は現実的である**（§1 のとおり造形 Z は 50 mm）。
それでも比較材料を出す。

| | **一体（採用）** | 上下 2 分割 |
|---|---|---|
| 造形 Z | **50 mm** | 50 mm（変わらない） |
| ベッド上の footprint | 84 x 198 mm | 84 x 100 mm x 2 |
| 造形の失敗リスク | 低い（背が低く、面積も枠内） | さらに低い |
| 造形時間 | 1 回で済む | 2 回（合計はほぼ同じか増える） |
| **接合部** | **無い** | **周長 約 270 mm の合わせ面が 1 つ増える** |
| **防水** | **貫通 4 つだけ** | 接合部の全周をシールする必要がある |
| 剛性 | **連続した箱** | 接合部が弱点。ねじれに弱くなる |
| 部品点数 | 本体 + 蓋 = 2 | 本体上 + 本体下 + 蓋 = 3 |
| 現地での扱い | **1 個** | 分解できてしまう（現地 UX 上は不利） |

**一体を推す。** 決め手は 2 つ。

1. **造形上の理由が無い。** 造形 Z は 50 mm で、ベッドの footprint 84 x 198 も
   256 x 256 に収まる。分割しても造形 Z は変わらない（低くならない）。
2. **接合部は貫通と同じく漏水の原因になる。** 周長 270 mm の合わせ面を
   1 つ増やすのは、貫通を 1 つ増やすより悪い可能性がある。

**分割を選ぶべき場合:** 実機で反りが出て一体では平面度が出ないと分かったとき。
そのときは**上下ではなく前後**（前面パネルを別部品にする）方が、接合部を
パッキンで押さえやすく、既にある蓋のパッキンと同じ設計を流用できる。

**採否は人間が決める。** この文書は判断材料である。

---

## 8. 現地 UX 原則の適用状況

| 原則 | 本設計での対応 | 状態 |
|---|---|---|
| 1 捕捉式のねじ | 蓋のシール面側に捕捉ポケット + 軸のリテーナ。`captive` が毎回検証 | ✓（D-020） |
| 2 数を減らして大きく | 蓋 6 本（M4 x5 + M5 x1）、ポッド 3 本、PIR 4 本 | **△ 面圧のため 4 -> 6 に増やした（D-019）** |
| 3 ポカヨケ | 蓋の 1 本だけ M5 + 中央の対が上下非対称。ポッドのねじは非等分 (90/200/320 度)。**トレーは -X の棚だけ段違い**（D-021） | ✓ |
| 4 パッキンの座りが見える | **未設計**（合わせ面の段差） | **宿題** |
| 5 刻印 | 本体に UP / WILDCAM、蓋に締める順序 1-2-3-4 と UP | ✓（内容は要追加） |
| 6 工具なし | ドームは嵌合、蓋は蝶ねじ | ✓ |
| 7 手順書 | `docs/field-procedure.md` | ✓（宿題つき） |

---

## 9. まだ設計していないもの

1. ~~**基板トレー**とクリック止め~~ -> **2026-08-23 に設計（D-021 / `docs/pcb-tray.md`）**。
   残るのは **Onyx の保持**（z 21〜136 に寝ているが何にも留まっていない）
2. ~~**蝶ねじの捕捉金具**~~ -> **2026-08-23 に設計（D-020 / `docs/captive-fasteners.md`）**
3. **合わせ面の段差**（パッキンの座りが見える。`docs/field-procedure.md` 宿題 3）
4. **前面の**リブの本数（たわみ計算をしていない。**蓋の方は D-019 で解いた**）
5. 合わせ面の**反りの実測**（`docs/lid-fastening.md` §6）。
   計算した弾性変形 0.08 mm より大きくなりうる。定盤に当てて測ること
6. ~~アリ溝の隙間~~ -> **この設計では使わなくなった**（D-021）。試験片は今後のために残す
7. ドーム嵌合部の 7 項目（`parts/dome_lid.UNMEASURED`。実測待ち）
8. 通気つきグランドの入手性確認（貫通が 4 -> 3 に減る）
