OdaijinSamaX/wildlife-cam/hardware/enclosure/docs/layout-study.md

# wildlife-cam カメラユニット 内部レイアウト検討

- 日付: 2026-08-22
- 状態: **比較検討。最終設計ではない。** 候補を並べて選べる状態にするのが目的
- 実装: `designs/wildlife_cam/layout_study_a.py` / `_b.py` / `_c.py`
- 共通の器: `designs/wildlife_cam/_layout_common.py`

```bash
uv run python -m harness check designs/wildlife_cam/layout_study_a.py
```

## 図（案ごとの内部の収まり）

外殻を半透明にして内蔵部品を色分けで重ねた図と、外殻も部品も同じ面で切った断面。
色と名前の対応は図の左上の凡例と、各部品の中心のラベルで分かる。

| | 内部の収まり (iso) | 前から | 上から | 断面 XZ | 断面 YZ |
|---|---|---|---|---|---|
| 案A | `out/layout_study_a/views/assy_iso.png` | `assy_front.png` | `assy_top.png` | `section_xz_mid.png` | `section_yz_mid.png` |
| 案B | `out/layout_study_b/views/assy_iso.png` | 同上 | 同上 | 同上 | 同上 |
| 案C | `out/layout_study_c/views/assy_iso.png` | 同上 | 同上 | 同上 | 同上 |
| 案D | `out/layout_study_d/views/assy_iso.png` | 同上 | 同上 | 同上 | 同上 |

`out/` は生成物なので Git には入っていない。次のコマンドで作り直せる。

```bash
for L in a b c d; do uv run python -m harness check designs/wildlife_cam/layout_study_$L.py; done
```

各案の `out/<design>/report.md` に、上記の図と全チェックの実測値がまとまっている。

3 案とも総合 **WARN**（穴の縁に幅 1 mm 未満の下向き面が 2 箇所出るだけ。ブリッジ可）。
`layout` チェックが部品同士の食い合いを、`clearance` が外殻と部品の干渉を、
`openings` が貫通の数を実測している。

---

## 0. 何が配置を支配しているか

**OTG ケーブルの USB-A メスを Onyx に挿した組立状態の実測全長 115.0 mm。**
これが箱の中を貫く曲がらない剛体の実長で、すべての案の長辺を決めている。

```
Onyx 実測    本体 77.5 + プラグ 11.9 = 89.4     （公称 95 とは 5.6 mm 食い違う。実測を採る）
組立         89.4 + USB-A ハウジング 35.0 - 差し込み代 9.4 = 115.0
後端 20.8 mm は厚み 9.3（面取り）              -> 脇に他の部品を寄せられる
```

次に効くのが **OTG ケーブルの可動長 84.2 mm**。両端のコネクタ 65.8 mm は曲げられない。
折り返し方はこの 84.2 mm で届く範囲でしか選べない。

3 番目が **PIR キャリアの φ52**。前面に 52 x 52 の場所を取る必要がある。

## 0.1 確定した前提

- **外部アンテナ (CRC9) は使わない。** ドングル単体で通信できることを実機で確認済み。
  そのぶん内蔵アンテナ 1 本なので、**Onyx を壁際に置き、金属と他の基板を近づけない**。
  3 案とも「アンテナ端 - 壁 3.0 mm / 他基板 10 mm 以上」を満たしている（機械チェック済み）。
- バッテリーは筐体の外。中に入れない。
- IR 投光器は別筐体。隔壁も発熱対策も不要。
- 電源ケーブルは外径 2.8 を自己融着テープで 5 mm 前後に増径して PG7 グランドに通す。
- Pi のコネクタは **すべて同じ長辺**に集中する。データ口と電源口の縁どうしのすきまは
  **4.5 mm**。OTG の micro-USB ハウジングは幅 9.9 mm なので、データ口の中心に合わせると
  片側 0.95 mm はみ出し、電源口の縁まで **3.55 mm** 残る。**干渉しない。**

## 0.2 モデルの限界（読む前に）

- 外殻は**単純な直方体シェル**。分割線・パッキン溝・ボス・リブ・補強は一切入っていない。
  **実物はここから 1 割前後は太る。**
- 部品は `parts/` の envelope ではなく**実寸 + 一律 1.0 mm のクリアランスの箱**で置いた。
  envelope には抜き差し代やアンテナ逃げが入っていて、相手のコネクタを別途置くと
  二重計上になるため。
- 蓋は **+Y 面（背面）を開けた本体だけ**をモデル化している。蓋そのものは未設計。
- Camera Module 3 は **2026-08-22 に実測済み**（レンズ 10.7 角 / 前面まで 7.6 /
  裏面 CSI 3.0）。**レンズは基板中心から FPC が出る辺の側へ 2.45 mm 寄っている**ので、
  3 案とも**窓は基板中心ではなくレンズ中心**に合わせてある。
  鏡筒が無く焦点は `LensPosition` で固定するので、機械的な調整代は不要
  （窓との逃げ 1.0 mm は AF ストロークぶんの推定）。
  **CSI コネクタが Pi のどこにあるかは未実測**なので、FPC の取り回しは仮のまま。

## 0.3 確認が要る点（指示との食い違い）

指示では貫通は **グランド / PIR / ベントの 3 つに確定**とされたが、**カメラ窓を
4 つ目として置いている。** カメラが外を見るには前面に開口が要り、透明窓を接着封止しても
漏水経路としては貫通と同じ扱いをすべきだと判断したため。3 つで確定するなら、
カメラをどう外に向けるかの方針（窓を前面パネルと一体にする等）を決める必要がある。

---

## 1. 3 案

### 案A — 平板 1 層

剛体ブロック 115.0 mm を X 方向に寝かせ、全部品を XZ 平面の 1 層に並べる。
ケーブルは Pi のコネクタ辺から -Z へ出し、箱の端で 1 回だけ回り込ませる。
奥行き (Y) は PIR キャリアの 22.7 mm で決まるので、**奥行きが最小になる代わりに
前面が最大**になる。

### 案B — 前後 2 層

Pi と OTG を前層 (y 0〜10)、剛体ブロックを後層 (y 14〜27) に置く。
**両者は Y で重ならない**ので、micro-USB ハウジングが Onyx の前を素通りできる。
これがこの案の折り返しの本質で、前面積を小さくできる。

### 案C — 縦置き

剛体ブロック 115.0 mm を Z 方向に立て、Pi をその横に寝かせる。ケーブルは Pi の
コネクタ辺から -Z へ出し、箱の底で Onyx の下端（USB-A 側）に回り込ませる。
**縦長・細身**になるので、幹に巻いたときの収まりがよい。

---

## 2. 比較表（すべて機械が出した実測値）

| 指標 | 案A | 案B | 案C |
|---|---|---|---|
| 外形 X/Y/Z (mm) | **137.8 x 35.5 x 112.0** | 137.8 x 40.4 x 145.9 | 117.9 x 35.5 x 176.0 |
| **外形体積 (cm3)** | **547.9** | 812.2 | 736.6 |
| **貫通の数** | 4 | 4 | 4 |
| 貫通の面 | -Y:2 / -Z:2 | -Y:2 / -Z:2 | -Y:2 / -Z:2 |
| 蓋になる面 | +Y（背面） | +Y（背面） | +Y（背面） |
| **合わせ面の周長 (mm)** | **499.6** | 567.4 | 587.8 |
| アンテナ端 - 壁 (mm) | 3.0 | 3.0 | 3.0 |
| アンテナ端 - 他基板 最小 (mm) | 12.2 | 12.1 | 10.1 |
| アンテナ配置ルール | OK | OK | OK |
| **OTG 経路長 (mm)** / 可動 84.2 | **31.3**（余裕 52.9） | 82.3（**余裕 1.9**） | 73.2（余裕 11.0） |
| 最大折れ角 (deg, 0=直線) | 45.0 | 20.9 | 33.6 |
| R15 に要る接線長 (mm) | 6.2 | 2.8 | 4.5 |
| カメラ - Pi 直線距離 (mm) | 37.4 | 52.5 | 76.0 |
| 造形姿勢 | 開口面を上（rotate 90,0,0） | 同左 | 同左 |
| サポート | **不要**（下向き面 52 mm2・span 1 mm 未満） | 同左 | 同左 |

### 2.1 貫通の数は 3 案とも同じ

**これ自体が結論。** 貫通の数はレイアウトでは減らない。グランド 1 / PIR 1 / ベント 1 /
カメラ窓 1 の 4 つで、どの案でも同じ。減らしたいなら**部品の選定で減らす**しかない:

- **通気機能つきケーブルグランド**を使えば、グランドとベントが 1 つになって **3 つ**になる。
  これはレイアウトとは独立に効くので、どの案を選んでも適用できる。
- カメラ窓を前面パネルと一体成形（透明材で刷る／窓板を接着）すれば、
  「穴」ではなくなるが、シール面は増える。

貫通の**向き**は 3 案とも同じにしてある。カメラと PIR は前面 (-Y)、
グランドとベントは**底面 (-Z)**。底に付ければ水が溜まらず、電源ケーブルも自然に垂れる。

### 2.2 ケーブルの曲げに無理はないか

可動長 **84.2 mm** に対して:

- **案A 31.3 mm** — 余裕 52.9 mm。曲げ半径をいくらでも大きく取れる。最も安全。
- **案C 73.2 mm** — 余裕 11.0 mm。R15 に要る接線長 4.5 mm も十分収まる。
- **案B 82.3 mm** — **余裕 1.9 mm**。数字上は届くが、**実物の個体差と組立誤差を
  吸収できない。** ケーブルの実長が 2 mm 短ければ届かない。この案を採るなら
  ケーブル長を測り直すか、経路を短くする作り直しが要る。

最大折れ角はどれも 45 度以下で、R15 で丸めるのに要る接線長（最大 6.2 mm）は
どの区間長にも収まっている。**曲げそのものは 3 案とも成立する。**

### 2.3 造形姿勢とサポート

3 案とも **開口面（背面）を上に向けて刷る**。閉じた箱は必ず天井ができて刷れないので、
本体は開口を上、蓋は平板として別に刷る。

この姿勢なら **3 案ともサポート不要**。下向きに残るのは前面の穴（PIR φ26 / カメラ φ16）の
縁に出る幅 1 mm 未満のひさしだけで、合計 52 mm2、ブリッジで渡せる。

前面の穴は**造形方向に対して横向き**なので、穴の真円度は落ちる。PIR 貫通口は
`pir_bezel` のキャリアが受けるので寸法精度は要らないが、カメラ窓を精度よく作りたいなら
前面を別部品にするか、窓だけ別に刷って接着すること。

### 2.4 現地でのサービス性

3 案とも**背面（樹側）が丸ごと蓋**なので、開ければ全部品に手が届く。
ただし現地では「箱を木から外さないと背面を開けられない」ことになる。

| | 案A | 案B | 案C |
|---|---|---|---|
| 蓋を開けたときの見え方 | 全部品が 1 層で並ぶ。**一目で全部見える** | 前層が後層を隠す。Pi を外さないと Onyx に触れない | 全部品が見える |
| microSD 抜き差し | Pi の SD 辺が蓋側を向くので **カード 4.1 + 指の代 25 mm を蓋側に確保できる** | 前層の Pi の SD 辺は蓋から遠い。要確認 | 同 案A |
| コネクタの抜き差し | 全部同じ長辺に集中。蓋側から真っ直ぐ抜ける | 同左だが前層が邪魔 | 同左 |
| 現地で開けやすいか | 背面が最大面（137.8 x 112.0）。ねじが多くなる | 同左 | 細長いので開口が狭い |

**microSD は現地で抜かない運用に決まった**（2026-08-22）。したがって
**SD 専用の小蓋は不要**で、シール面が 1 つ減る。データは LTE 経由で吸い上げる。
蓋を開けるのは修理と部品交換のときだけになる（`docs/field-procedure.md` C）。

### 2.5 取り付け方法（提案のみ。固定しない）

| 案 | 形の性質 | 合いそうな方式 |
|---|---|---|
| A | 前面が広く薄い（137.8 x 112 x 34.7） | 背板に平ベルトを 2 本通して木に巻く。面で当たるので樹皮の凹凸を吸収しやすい |
| B | ほぼ立方体に近い（137.8 x 145.9 x 39.6） | 背面に半割りクランプを付けて柱・杭に締める。厚みがあるのでブラケットを付けやすい |
| C | 縦長で細い（117.9 x 34.7 x 176.0） | 幹にラチェットバンド 2 本で縦に縛る。見た目が目立ちにくい |

いずれも**取り付け部は貫通させない**こと（ベルト通しは外付けのループ、クランプは
背面のボスに止まり穴）。取り付けのために穴を開けたら、貫通が 4 から増えてしまう。

---

## 3. （旧）推奨: 案A — **§5 で覆った**

> **この節の結論は §5 で覆っている。** 現地写真から幹の直径が 48〜64 mm と
> 判明し、取り付けの評価軸が変わったため。以下は「幹の情報が無かった時点での
> 判断」として残す。判断が何によって覆ったかを追えるようにするため。

### 旧推奨: 案A（平板 1 層）

理由を効く順に。

1. **外形体積が圧倒的に小さい。547.9 cm3 は 案B の 67%、案C の 74%。**
   材料も造形時間も比例して減り、木に付けたときの風荷重も小さい。
2. **ケーブルの余裕が 52.9 mm ある。** 案B の 1.9 mm は、実物の個体差を吸収できない。
   レイアウトは「机上で成立する」だけでは足りず、**組み立てられる**必要がある。
   ここが 3 案で最も差がついた。
3. **合わせ面の周長が最短（499.6 mm）。** パッキンの長さ = 漏水経路の長さなので、
   短いほど有利。案C より 88 mm 短い。
4. **1 層なので蓋を開ければ全部品が一目で見える。** 現地での作業は暗く、寒く、
   手袋をしていることを前提にすべきで、「重なっていて見えない」は事故のもと。
5. **カメラ - Pi 距離が 37.4 mm と最短。** CSI の FPC が未実測なので、
   ここに余裕があるのは効く。案C の 76.0 mm でも実効 100〜120 には収まるが、
   コネクタの向きが悪ければ足りなくなる。

**案A の弱点と対処:**

- **前面が最大（137.8 x 112）。** 平らな大面積は圧力差でたわむので、
  蓋にリブを入れるか、中央付近にもう 1 本ねじを足すこと。
- 木の幹が細いと、平らな背面が当たらない。ここは実地で決めること。
  -> **実測は 48〜64 mm で、この記述の想定より桁が小さかった。§5。**

**案C を採るべき場合:** 細い幹に縦に縛る前提が固いとき。体積は 34% 増えるが、
ケーブル余裕 11.0 mm もアンテナ離隔 10.1 mm も成立している。
-> **実際に細い幹だった。§5 を見ること。**

**案B は推奨しない。** 前後 2 層は「前面積を小さくする」ために選ぶ形だが、実際には
案A より体積が 48% 大きく、ケーブル余裕が 1.9 mm しかなく、サービス性も最も悪い。
2 層にする利点が出ていない。

---

## 4. 次に決めること

1. **貫通は 3 つか 4 つか。** カメラ窓の扱い（0.3 節）。
2. **取り付け対象**（木の幹径 / 柱 / 杭）。案A と案C の分かれ目はここだけ。
3. ~~microSD を現地で抜く運用にするか~~ -> **抜かない運用に決定。小蓋は不要。**
4. **Pi 側の CSI コネクタ位置の実測。** カメラ基板自体は実測済みだが、
   FPC がどちらへ何 mm 走るかが決まらない。
5. 通気機能つきケーブルグランドを使うか（貫通が 4 -> 3 に減る）。
6. 蓋の分割位置・パッキン溝・ねじピッチ・リブ（この検討では未設計）。

---

## 5. 取り付けの評価やり直し（現地情報を受けて・2026-08-22）

現地写真から設置対象が判明したので、§2〜§3 の推奨を評価し直した。

### 5.1 判明したこと

| | 内容 | 効き方 |
|---|---|---|
| 1 | **幹の円周 15〜20 cm = 直径 48〜64 mm** | §3 は「幹径 150 mm 以下なら案C」と書いていたが、**桁が違った** |
| 2 | **木は細く、しなる** | **重量と受風面積が想定より強く効く** |
| 3 | 現行機はタッパー + 透明カップ + 瞬間接着剤。密閉ではない | 今回の設計はその置き換え |
| 4 | カメラユニットと IR ユニットは別の木。2〜3 m 離れている | この箱に IR は入らない（既知） |

### 5.2 鞍（さや）は必須要件になった

**直径 50 mm の丸い幹に、137.8 x 112 の平面を当てても線接触にしかならない。**
ベルトで締めても回転し、風で振られる。したがって

> **背面に幹の丸みに合わせた鞍状の凹みを設けることが必須。**

印刷では形を変えるだけなので追加コストは無い（材料と奥行きは増える）。

**採用した形: V 溝。** 幅 44 / 深さ 16 mm。

- V 溝は**直径 48〜64 mm の範囲で 2 線接触**になり、径が変わっても座りが安定する。
  円弧だと 1 つの径にしか合わず、細い幹では底で 1 点接触、太い幹では縁で 2 点接触になる。
- 幾何: 半角 α = atan(22/16) = 54 度。半径 r の幹の中心は V の頂点から
  `r / sin(54 度) = 1.24 r` の高さに座る。r=24 で 29.7、r=32 で 39.6。
  **どちらも V の壁の中で接触する。**
- **鞍は奥行きのコスト**として計上してある（4 案とも Y が +16 mm）。

### 5.3 ベルト溝

ベルトを木に何重にも巻いて金具で締める方式なので、**鞍の中にベルトの通り道を
彫って上下にずれないようにする。**

- 位置: 箱の高さの 25% と 75% の 2 本
- **幅 30 mm**（何重にも巻ける幅を確保）
- 深さ: 鞍の面よりさらに 3 mm 深く彫る
- **鞍の V 面とベルト溝は同じ V の延長**にしてあるので干渉しない
  （ベルト溝は同じ角度でより深いだけ）

### 5.4 案D を追加した

案A〜C はいずれも幅 118〜138 mm で、**直径 50 mm の幹に対して片側 35〜45 mm も
張り出す**。これは風でねじれる「てこ」になる。

そこで**幅を最小化することだけを目的にした案D**を作った。剛体ブロック 115 mm を
縦に立て、Pi は横向きのまま上に載せ、PIR とカメラも同じ縦の列に並べる。
幅は Pi の 65 mm と PIR キャリアの φ52 で決まる。

### 5.5 比較（鞍を入れた後の実測値）

| 指標 | 案A | 案B | 案C | **案D** |
|---|---|---|---|---|
| 外形 X/Y/Z (mm) | 137.8 x 51.5 x 112.0 | 137.8 x 56.4 x 145.9 | 117.9 x 51.5 x 176.0 | **77.0 x 50.7 x 229.0** |
| 外形体積 (cm3) | **794.8** | 1133.9 | 1068.6 | 894.0 |
| **前面投影面積（受風）(cm2)** | **154.3** | 201.1 | 207.5 | 176.3 |
| **幹からの横張り出し 片側 (mm)** | 44.9 | 44.9 | 35.0 | **14.5** |
| **鞍の接触長 = 縦の寸法 (mm)** | 112.0 | 145.9 | 176.0 | **229.0** |
| **受風面積 / 接触長 (mm)** | 137.8 | 137.8 | 117.9 | **77.0** |
| 重心 - 幹軸 距離 (mm) | 61.8 | 57.7 | 61.8 | 61.7 |
| 総質量の目安 (g) | **150.6** | 180.7 | 176.0 | 166.8 |
| 転倒モーメントの目安 (g x mm) | **9304** | 10426 | 10877 | 10289 |
| OTG 経路長 / 可動 84.2 (mm) | **31.3** | 82.3 | 73.2 | 34.7 |
| アンテナ配置ルール | OK | OK | OK | OK |
| 貫通の数 | 4 | 4 | 4 | 4 |

質量は「外殻の体積 x ASA 1.07 g/cm3 + 部品の実測質量」の概算。
重心は部品質量で重み付けした位置。**いずれも目安**であって設計値ではない。

### 5.6 細い幹で効く指標はどれか

風で揺れる細い木に付けた箱に効くのは、次の 3 つ。

1. **横張り出し（ねじりのてこ）** — 幹の左右にはみ出したぶんが、横風で
   幹軸まわりにねじる。**案D が 14.5 mm と圧倒的に小さい**（案A の 1/3）。
2. **受風面積 / 鞍の接触長** — 風荷重を、ベルトが押さえる長さで割った値。
   小さいほど「長い面で受け止められている」。**案D が 77.0 で最良**（案A の 56%）。
3. **総質量** — 細い木のしなりを増やす。**案A が 150.6 g で最軽量**、
   案D は 166.8 g で +11%。

**案A は「軽くて小さい」が「幹に対して広がりすぎ」。**
**案D は「少し重い」が「幹に沿う」。**

転倒モーメントの目安（質量 x 重心距離）では 案A が最小だが、この指標は
**静的な重さしか見ておらず、風のねじりを見ていない。** 細い木では風が支配的
なので、1 と 2 を優先すべきである。

### 5.7 **推奨を 案D に変更する**

理由を効く順に。

1. **幹からの張り出しが片側 14.5 mm。** 案A の 44.9 mm に対して 1/3。
   直径 50 mm の幹に幅 77 mm の箱なので、**ほぼ幹の幅に収まる。**
   横風でねじる力が根本的に小さい。
2. **鞍の接触長が 229 mm。** ベルトを 2 本掛けたときの支点間距離が長く、
   ピッチ方向（お辞儀する向き）に強い。案A の 112 mm では上下に振られる。
3. **受風面積 / 接触長 が 77.0 と最良。** 受ける力に対して押さえる長さが十分ある。
4. ケーブル余裕 49.5 mm（84.2 - 34.7）で、**案A に次いで安全**。
5. アンテナ配置ルールを満たす。貫通は 4 で全案同じ。

**払うコスト:**

- 体積 +12%（794.8 -> 894.0 cm3）、質量 +11%（150.6 -> 166.8 g）
- **高さ 229 mm。** P1S の 256 枠には収まるが、余裕は 27 mm しかない。
  蓋のリブやボスを足すと**造形できなくなる危険がある。**
  -> **本設計に入る前に、229 mm のまま外殻を作れるか確認すること。**
- 縦長なので、幹の途中に枝があると付けられる場所が限られる

**案A を採るべき場合:** 幹がもっと太い個体（直径 100 mm 以上）に付けると
決まったとき。張り出しの不利が消え、最軽量・最小体積が効く。

**案B・案C は不採用。** 案B はケーブル余裕 1.9 mm で組み立てられない。
案C は案D の劣化版（幅 117.9、体積 +19%）で、選ぶ理由が無い。

### 5.8 木を傷めないために

若い木なので、ベルトが成長を締め付ける。設計と運用の両方で配慮する。

- **幅の広いベルト（25 mm 以上）を使う。** 細い紐は食い込みが早い。
  ベルト溝を 30 mm 幅にしてあるのはこのため。
- **ベルトと幹の間に緩衝材（ゴム板・古いホース）を挟む。**
- **毎回の巡回でベルトと幹の間に指が入るか確かめ、入らなければ緩める。**
- **1 年に 1 回は付け替える**（同じ位置で締め続けない）。
- **幹に釘・ねじを打たない。** 木材腐朽菌の入口になる。

手順は `docs/field-procedure.md` §D。
**宿題:** 「指が 1 本入る隙間」の目安を鞍の脇に刻印すること。

### 5.9 まだ決まっていないこと

1. **高さ 229 mm が造形枠に収まるか**（リブ・ボスを足した後で再確認）
2. 鞍の V 溝 44 x 16 は**幾何学的に座るところまでしか見ていない。**
   実際に幹に当てて滑らないかは未検証
3. ベルトの本数・幅・金具の種類
4. 枝の位置によって縦長が付けられない場合の代替
