OdaijinSamaX/wildlife-cam/hardware/enclosure/docs/lid-fastening.md

# 蓋の締結 — 四隅 4 点で長辺中央のパッキンが浮くか

- 日付: 2026-08-23
- 対象: `designs/wildlife_cam/camera_unit_lid.py` / `camera_unit.py`
- 実装: 締結点を **4 点 -> 6 点**（中央に 1 対追加）。`seal` チェックを新設
- 出発点: **人間の指摘**「長辺 198 mm を四隅 4 本だけで押さえて、辺の中央で
  パッキンの面圧が足りるのか」

---

## 0. 結論

**指摘は正しい。四隅 4 点では中央で圧縮率が 25% -> 13.3% に落ち、静的シールの
下限 15% を割る。** ただし**浮き方は前回の粗い見積り（0.85 mm）ほど大きくない**。
実際の浮きは **0.23 mm** で、前回の数字は 3.7 倍の過大評価だった（§3）。
それでも足りないのは、**使える予算が 0.50 mm ではなく 0.20 mm しかない**からである。

| | 四隅 4 点（現状） | **6 点（採用）** | 6 点 z=99（Onyx を動かせば） |
|---|---|---|---|
| 締結点 z | 12 / 186 | **12 / 142 / 186** | 12 / 99 / 186 |
| 最大間隔 | 174 mm | **130 mm** | 87 mm |
| 中央の浮き | 0.233 mm | **0.080 mm** | 0.012 mm |
| **最小圧縮率** | **13.3%（下限割れ）** | **21.0%** | 24.4% |
| ねじ 1 本あたりの力 | 193 N | 185 N | 173 N |

（ASA の実効弾性率係数 0.6 / パッキン 70 Shore A。感度は §4）

**採った手当ては「中央に締結点を 1 対足す」だけ**である。高さも幅も張り出しも
増えていない。**剛性で直す案（リブ・厚板）は桁が足りない**（§5.2 で数値化）。

中央の対を長辺の真ん中（z=99）に置けば余裕はさらに増えるが、そこには Onyx がいて
D-006（アンテナは壁際）に触る。**2026-08-23 に人間が「Onyx は動かさない」と決めた**
ので、**z=142 で確定**である（§7）。

---

## 1. 何を計算したか

蓋を **z 方向に伸びる 1 本の梁**、パッキンを **非線形の弾性床**とみなして解く。

```
   締結点            締結点             締結点
     |                 |                  |
 ====o=================o==================o====      蓋（梁・断面 I(z)）
     ^  ^  ^  ^  ^  ^  ^  ^  ^  ^  ^  ^  ^  ^        パッキンの反発 w(s)
 ------------------------------------------------    本体のリム（剛体とみなす）
```

実装は `harness/seal.py`、毎回の検証は `seal` チェック（`harness/checks/seal.py`）。
**設計側は寸法を書かない。** 断面二次モーメントは `build()` した形状を
0.4 mm の板でスライスして体積特性から実測する。宣言と実物がずれない。

### 1.1 なぜ「浮き = たわみ」ではないのか

締結点では**蓋の合わせ面が本体の land に当たって止まる**（ハードストップ）。
だから潰し量はそこで頭打ちになる。

```
密着時の潰し量 s0 = コード径 2.00 - 溝深さ 1.50 = 0.50 mm （= 圧縮率 25%）
中央が u だけ浮けば、そこの潰し量は s0 - u
```

**使える予算は 0.50 mm 全部ではない。** 静的フェイスシールが成立する下限を
15%（= 0.30 mm）とすると、**許される浮きは 0.20 mm**。目標 20% で見れば 0.10 mm。

| 圧縮率 | 意味 | 判定 |
|---|---|---|
| 15% 未満 | 面の粗さを埋めきれず漏れる | **FAIL** |
| 15 〜 20% | 成立はするが、クリープと反りの余地が無い | WARN |
| 20 〜 35% | 静的シールの常用域 | PASS |
| 35% 超 | 圧縮永久ひずみが出て、次に開けたとき戻らない | WARN |

### 1.2 パッキンの反発力（式と出所）

**ゴムのヤング率（Gent の式。Shore A 硬度から）**

```
E [MPa] = 0.0981 (56 + 7.62336 S) / (0.137505 (254 - 2.54 S))
```

**O リングを平板で潰すのに要る線圧（Lindley 1966）**

```
w(eps) = E * d * (1.25 eps^1.5 + 50 eps^6)      [N/mm]      eps = 潰し量 / コード径
```

| 硬度 | E [MPa] | φ2.0 を 25% 潰す線圧 | 周長 540 mm の合計 |
|---|---|---|---|
| 40 Shore A | 1.69 | 0.57 N/mm | 307 N |
| 50 Shore A | 2.46 | 0.83 N/mm | 447 N |
| **70 Shore A（設計値）** | **5.52** | **1.86 N/mm** | **1004 N** |
| 90 Shore A | 20.84 | 7.02 N/mm | 3792 N |

**この式は「潰すほど急に硬くなる」ことを表している**（eps^1.5 と eps^6）。
だから逆に、蓋が浮くとパッキンの押し返しは急速に弱まる。ここが効く（§3）。

### 1.3 梁

2 節点の Hermite 梁要素（Euler-Bernoulli）。要素ごとに EI を変え、締結点は
変位 0 の拘束、パッキンは節点に集めた非線形バネとして Newton 法で解く。

**モデル自体の検証**（`tests/test_seal_model.py`）:

- 一定断面・等分布荷重・単純支持 -> `5wL^4/384EI` と 1% 以内で一致
- 支間を半分にすると **1/16 x 0.415**（2 連梁の係数）になる
- 断面二次モーメントの実測が `b h^3 / 12` と一致

### 1.4 実測した断面二次モーメント

| z | 何があるか | I [mm4] |
|---|---|---|
| 12 / 142 / 186 | 締結点（座ぐりで肉が減る） | 42,000 〜 43,200 |
| 49.5 / 164.3 | ベルト溝（V が広がってレールが痩せる） | 49,176 |
| 99 | 鞍だけ | 54,896 |

**前回の見積りが使った 28,128 mm4 は「V 溝の外に残るレール 2 本」だけを数えた
値**で、その 2 本を繋いでいる底の板（鞍の V の下に残る肉）を落としていた。
実物は 1.5 〜 1.9 倍ある。

---

## 2. 仮定（結論はここに依存する）

| # | 仮定 | 向き | 備考 |
|---|---|---|---|
| 1 | ASA の曲げ弾性率 2000 MPa | — | メーカー公称のあたり。**実測していない** |
| 2 | 印刷品の実効係数 **0.6** | — | 疎充填ぶんと shear lag をまとめた割引。**推定**。§4 で感度を出す |
| 3 | 本体のリムは剛体 | 安全側 | 側壁は合わせ面の荷重を**面内**で受ける深い板。蓋よりはるかに硬い |
| 4 | 平面保持（Euler-Bernoulli） | 危険側 | 幅 84 に対しスパンが短く shear lag が効く -> 仮定 2 に含めた |
| 5 | せん断たわみを無視 | 危険側 | L/h ≈ 6 で +5〜10% -> 同上 |
| 6 | ボルトの位置 (x=±31) とパッキン (x=±39) のずれによるレールの倒れを無視 | ほぼ影響なし | **land が溝の真下 (x 37〜42) にある**ので、倒れは land への押し付けに変わり、潰し量には効きにくい |
| 7 | クリープと圧縮永久ひずみを無視 | **危険側** | ここで出るのは「締めた直後」。§6 |
| 8 | 合わせ面は平ら | **危険側** | 反りは計算で出せない。§6 |

---

## 3. 前回の一次見積り（0.85 mm）はどこが違ったか

引き継ぎ文書（旧 §2。いまは書き換えてある）に
書いてあった一次見積りと、その訂正。**前回の数字を引用して比べる人がいるので残す。**

| 項目 | 前回 | 今回 | 差の理由 |
|---|---|---|---|
| 断面二次モーメント | 28,128 mm4 | **43,000 〜 55,000 mm4** | レール 2 本だけを数えていた。実物をスライスして測った |
| パッキンの線圧 | 4 N/mm（出所なし） | **1.86 N/mm** | Gent + Lindley で導出。70 Shore A / φ2.0 / 25% |
| パッキン周長 | 760 mm | **540 mm** | レーストラック 2x192 + 2x78。760 の出所は不明 |
| 合計座面力 | 2.3 〜 3.8 kN | **0.94 kN** | 上 2 つの帰結 |
| 荷重のモデル | 浮いても線圧は一定 | **浮けば急に弱まる**（弾性床） | Lindley の式そのもの |
| **中央の浮き** | **0.85 mm** | **0.233 mm** | 上の合計 |
| 判定の基準 | 潰し代 0.50 mm を使い切るか | **15% (0.30 mm) を残せるか** | 使える予算は 0.20 mm しかない |
| **結論** | 確実に浮く | **足りない（13.3% < 15%）** | **同じ** |

**粗い上限（剛体パッキン・単純支持）と突き合わせておく。**

```
5 w L^4 / (384 E I) = 5 x 3.72 x 174^4 / (384 x 1200 x 54896) = 0.674 mm
```

弾性床で解くとこれが 0.233 mm まで落ちる。**浮いたぶんだけパッキンが押し返さなく
なるから**で、この 2.9 倍が「粗い上限」と「実際」の差である。粗い上限は
**必ず安全側に外す**ので、桁の確認にしか使わない（`seal.rigid_gasket_bound()`）。

---

## 4. 感度（どこまで信じてよいか）

実効弾性率の係数（充填率・shear lag・クリープをまとめたもの）と、パッキンの硬度を
振ったときの最小圧縮率。**下限 15% を割る組み合わせを太字にした。**

| 締結点 | 係数 1.0 / 70A | 0.6 / 70A | 0.4 / 70A | 0.3 / 70A | 0.6 / 50A | 0.3 / 50A |
|---|---|---|---|---|---|---|
| 4 点 (12/186) | **15.9%** | **13.3%** | **11.3%** | **9.8%** | 17.4% | **13.9%** |
| **6 点 (12/142/186)** | 22.3% | **21.0%** | 19.6% | 18.4% | 22.9% | 21.3% |
| 6 点 (12/99/186) | 24.6% | 24.4% | 24.1% | 23.9% | 24.7% | 24.5% |

**読み方:**

- **4 点はどの組み合わせでも下限を割るか、ぎりぎり**。係数を最も甘く（1.0 =
  中身が実体）取っても 15.9% しかなく、目標 20% には届かない。
- 6 点なら**係数を 0.3（＝ EI が半分に落ちる想定）まで悪くしても 18.4%** で、
  下限 15% を割らない。**この余裕がクリープと反りの取り分になる。**
- z=99 に置ければ係数にほとんど依存しなくなる。**支間を短くするのが最も効く**
  （たわみは L^4 で効くので）。

---

## 5. 比較した案

制約は 3 つ。**(a) 現地で保守する人は機械に強くない** / **(b) 高さ 198 mm を
増やさない** / **(c) 幹からの張り出し（幅 84 mm）を増やさない**。

| 案 | 効き（最小圧縮率） | (a) 現地 | (b) 高さ | (c) 張り出し | 判定 |
|---|---|---|---|---|---|
| **A2 中央に 1 対追加 (z=142)** | **13.3 -> 21.0%** | ねじが 4 -> 6 本に増える | 変わらず | 変わらず | **採用** |
| A3 中央を z=99 に置く | 24.4% | 同上 | 変わらず | 変わらず | **Onyx が邪魔（§7）** |
| A1 4 点のまま内側へ (45/153) | 18.4% | **ねじは 4 本のまま** | 変わらず | 変わらず | **左 z=45 に Onyx がいて不可** |
| B 蓋の外面にリブ | §5.2 | — | — | **鞍と幹に当たる** | 不可 |
| C 蓋を厚くする | §5.2 | — | 変わらず | 奥行きが増え、**幹からの距離＝風のてこが伸びる** | 不可 |
| D コード径を上げる | §5.3 | — | — | — | **効かない・溝も入らない** |
| E 柔らかいパッキン | 13.3 -> 17.4%（50A） | 入手性は同等 | — | — | **単独では不足。併用は有効** |
| F 金属の補強材を蓋に埋める | 大きい | 交換不能 | 変わらず | 変わらず | **内蔵アンテナの近くに金属（D-006 違反）** |
| G 繊維入りフィラメント | 中 | — | — | — | 補正テーブルの再校正が要る。CF は**アンテナに悪い** |
| H トグルラッチ | 大きい | 工具不要で良い | 変わらず | **側面に付くので幅が増える** | D-014 で却下済み |

### 5.1 なぜ「締結点を増やす」以外に手が無いのか

たわみは **支間の 4 乗**で効き、**EI に反比例**する。支間を 174 -> 130 mm に
縮めるのは EI を 3.2 倍にするのと同じで、**中央に 1 対足すだけで得られる**。

### 5.2 剛性で直すといくら要るか（案B・C の定量的な却下）

4 点のまま最小圧縮率 20% にするのに必要な EI を二分探索で求めた。

```
必要な EI = いまの 4.2 倍
= 断面高さを 22 mm -> 36 mm にするのと同等（幅は増やせないので高さで稼ぐしかない）
```

**蓋が 14 mm 厚くなる。** 箱が幹から 14 mm 遠ざかり、風のねじりのてこが伸びる。
案D を選んだ理由（張り出しを減らす）を自分で壊すことになる。**却下。**

なお外面にリブを立てる案（B）は、**そこが鞍の V の中＝幹の当たる面**なので
そもそも置けない。V の外（レールの上）に足すと、V の斜面を延長する形にしかならず、
ベルト溝がレールを削る量が増えて**逆に断面が痩せる**。

### 5.3 コード径を上げても比は変わらない（案D の却下）

ハードストップのある継手では、**コード径を変えても「浮き / 予算」の比はほぼ動かない**。

```
浮き       ∝ 線圧 w ∝ E d eps^1.5
予算       ∝ d (eps - eps_min)
```

φ3.0 コードにすると線圧が 1.5 倍になり、予算も 1.5 倍になって**差し引きゼロ**。
しかも溝幅が 4.05 mm になり、**本体の land 5 mm には両側の肉が残らない**（不成立）。
圧縮率を 35% に上げる案も同じ理由で効かない（eps^1.5 で荷重の方が速く増える）。

### 5.4 柔らかいパッキン（案E）は「併用すると効く」

70 -> 50 Shore A で線圧が 45% に落ちる。**単独では 4 点を救えない**（17.4%）が、
6 点と併せると 22.9% になり、クリープの取り分が増える。

**材質の申告を設計に入れた**（`gasket_shore_a` / `gasket_material`）ので、
硬いゴムを買ってきたら `seal` チェックが WARN / FAIL を出す。
**屋外なので UV とオゾンに強い EPDM かシリコーンを使うこと。NBR は紫外線で割れる。**

---

## 6. 計算では出せないので実機で見ること

**この 2 つは、ここで計算した弾性変形（0.08 mm）より大きくなりうる。**

1. **合わせ面の反り。** 198 mm の ASA を刷れば必ず反る。**定盤（またはガラス板）に
   当てて隙間ゲージで測ること。** 0.2 mm 反っていれば、それだけで圧縮率が 10 ポイント
   飛ぶ。反りが大きければ、締結点を増やすより先に造形の方（ブリム・チャンバー温度・
   分割）を見直す話になる。
2. **クリープと圧縮永久ひずみ。** ASA も O リングも、荷重が続けば流れる。
   月単位で潰し量は減る。ここで出した 21% は**締めた直後**の値である。
   -> §4 の「係数 0.3 でも 18.4%」がこのための余裕。

**確認の手順（実機ができたら）:**

1. 蓋の合わせ面を定盤に当て、四隅と長辺中央で隙間を測る（反りの実測）
2. パッキン無しで蓋を締め、合わせ面の隙間を全周見る（当たりの実測）
3. パッキンを入れて締め、**開けたときの O リングの当たり跡**を見る。
   全周で均一な帯になっていれば面圧は回っている。中央で細ければ浮いている
4. 3 は 1 週間後・1 ヶ月後にも見る（クリープ）

---

## 7. 中央の対を z=99 に移す案 — **不採用（2026-08-23 人間が決定）**

> **決定: Onyx は動かさない。中央の対は z=142 のまま確定。**
> 以下はその判断の材料として残す（同じ検討を二度やらないため）。

### 中央の対を z=99（長辺の真ん中）に置けないか

置ければ最小圧縮率は 21.0% -> **24.4%**、しかも実効弾性率の推定にほとんど
依存しなくなる（§4）。**いま置けないのは、そこに Onyx がいるからである。**

```
左の柱 (x = -31) が通れる z          Onyx    z  21 〜 136（x -36.0 〜 -0.2）
  z 3 〜 21   … 下の締結点で使用中     Pi      z 148 〜 178（x -32.5 〜 32.5）
  z 136 〜 148 … ここに入れた（z=142）
  z 178 〜 195 … 上の締結点で使用中
```

柱は前壁から背面の land まで通さないと造形できない（宙に浮いた柱は刷れない）ので、
**z=99 の左側に柱を立てるには Onyx をどかすしかない。**

| 動かし方 | 得られるもの | 壊れるもの |
|---|---|---|
| Onyx を x 方向に約 10 mm 内側へ | z=99 に柱が立つ。24.4% | **D-006「Onyx は壁際に置く」に触る**（内蔵アンテナ 1 本。壁まで 3 mm -> 13 mm）。OTG の経路も引き直し |
| Onyx を z 方向に下げる | 4.4 mm しか下げられない（下の締結点に当たる）。ほぼ効果なし | — |
| **動かさない（採用）** | 21.0%。§4 のとおり係数 0.3 でも 18.4% | 何も壊れない |

**判断（2026-08-23・人間）: Onyx は動かさない。** 21.0% は目標を満たしており、
レイアウトは D-008 / D-013 で比較検討して決めた結果なので、面圧のために崩さない。
**この件は決着した。蒸し返さないこと。**

再燃しうる条件は 1 つだけ: **実機で合わせ面の反り（§6）が大きく、21% では
足りないと分かったとき。** そのときも z=99 に移す前に、**まず反りそのものを潰す**
（造形条件・分割）方を先に検討すること。

---

## 8. 実装したこと

| # | 変更 | 場所 |
|---|---|---|
| 1 | 締結点を 4 -> **6 点**（中央 z=142 に 1 対） | `camera_unit.PARAMS["lid_bosses"]` |
| 2 | `lid_bosses` の**並び順 = 現地で締める順序**（中央 -> 対角 -> 対角） | 同上 |
| 3 | ポカヨケが 2 重になった（M5 が 1 本 + **中央の対が上下非対称**） | 同上 |
| 4 | 上のベルト溝を z 148.5 -> **164.3** へ（**蝶ねじの上にベルトが乗らないように**） | `camera_unit_lid.PARAMS["belt_z"]` |
| 5 | 刻印 1〜6 を**側面**に移した（座ぐりとの間に 1.6 mm の肉が残らない / ベルトに隠れる） | `camera_unit_lid._label` |
| 6 | **`seal` チェックを新設**。合わせ面を宣言すると毎回この計算が回る | `harness/seal.py` / `harness/checks/seal.py` |
| 7 | ネガティブテスト（4 点に戻すと FAIL / 硬いゴムで WARN） | `tests/test_checks_negative.py` |
| 8 | モデル自体の検証（閉じた式との突き合わせ） | `tests/test_seal_model.py` |
| 9 | **背面リムの不具合を修正**（合わせ面が 2 mm に痩せていた。§8.1） | `camera_unit._shell` |

**造形への影響:** サポートは要らないまま（下向き面はすべて渡り幅 10 mm 以下）。
造形枠 84 x 198 x 22 mm（蓋）/ 84 x 198 x 48 mm（本体）で変わらず。

### 8.1 ついでに見つかった不具合: 合わせ面が 5 mm ではなく 2 mm しか無かった

**面圧を確かめるために「パッキンが何に当たっているのか」を実際の形状で測ったら、
当たる相手が痩せていた。**

```
背面リムの押し出し量に、切り抜き用の「+1」がそのまま入っていた
  -> land だけが背面 (y=47) より 1 mm 飛び出す (y=48)
  -> 合わせ面の幅が x 37〜42 (5 mm) ではなく x 37〜39 (2 mm) になる
  -> 蓋のパッキン溝 (x 37.65〜40.35) が段差の縁 (x=39) に**跨がる**
  -> 溝の外側半分は 1 mm の空中。O リングは段差の角で押される
```

**どのチェックにも掛からない。** 穴ではないので `openings` は見ず、
ソリッドは 1 個なので `interference` も `layout` も鳴らず、肉厚は足りているので
`wall` も通る。`seal` チェックも「land はある」前提で解いている。

修正は `_shell()` の 1 箇所（`p["rim_t"] + 1` -> `p["rim_t"]`）。
**再発防止のテストを足した**:
`tests/test_camera_unit.py::test_body_land_carries_the_whole_gasket_groove`
が、蓋の溝の帯を本体の合わせ面の高さに置いて **「帯が本体からはみ出す体積が 0」**
であることを見る。

### 8.2 ベルトと蝶ねじの位置関係（見落としやすい）

**蓋は幹に巻いたベルトで押さえられている。** つまり現地で蓋を開けるとき、
ベルトは付いたままである。**ベルトの下に来た蝶ねじは回せないし、刻印も読めない。**

```
z   0                     50                    142      164        186   198
    |----+----------------[ベルト1]-------------+--------[ベルト2]---+----|
         ねじ(下)                              ねじ(中)             ねじ(上)
```

`tests/test_camera_unit.py::test_belts_do_not_cover_the_thumbscrews_or_the_labels`
が機械で押さえている。**ベルトの位置を触るときはこのテストを見ること。**

副次的に、ベルトの支点間が 99 -> 114.8 mm に広がった（揺れに対して有利）。

---

## 9. この検討から出た宿題

1. **合わせ面の平面度の実測**（§6）。**計算より効く可能性がある**
2. **蝶ねじ 6 本は現地 UX 原則 2「数を減らして大きく」と逆行する。**
   面圧の要求（この文書）と現地の使いやすさのトレードで、いまは面圧を採った。
   実機で「6 本は多い」となったら、§7 の z=99 に移して 6 本のまま余裕を増やすか、
   トグルラッチ（幅が増える）を再検討することになる
3. **蝶ねじの捕捉金具が未設計**（6 本ぶんに増えた）。`docs/field-procedure.md` 宿題 1
4. **合わせ面の段差（座りが見える）が未設計。** 浮きは 0.08 mm で目には見えないので、
   **段差の設計は「浮きを見るため」ではなく「締め忘れを見るため」**と割り切る
5. 基板トレーは **z=142 と 186 の柱を避けた形**にすること（レールは z 128〜194）
