OdaijinSamaX/wildlife-cam/hardware/enclosure/docs/field-procedure.md

# 現地作業手順（下書き）

- 日付: 2026-08-22
- 状態: **下書き。** 実機ができたら現地に持っていく手順書の元になる
- 前提: `docs/AGENTS.md` §4.9「現地で保守する人のための設計原則」

**この手順を読むのは、機械に強くない人である。** 暗く、寒く、手袋をしていて、
説明書はこの紙 1 枚しか無い。だから **1 手順 1 行、迷う余地を作らない**。

各手順のあとに *[点検]* を付けて、その手順が原則を満たしているか自己点検した。
満たしていないものは **設計の宿題**として残す。

---

## A. 定期巡回（3 〜 6 ヶ月ごと / 15 分）

1. **箱に触れる前に、正面から写真を 1 枚撮る。**
   ドームの曇り・汚れ・ひび、ベルトのずれを後で比べるため。
   *[点検]* 工具ゼロ。◎

2. **ドームを覗いて曇りを見る。** 白く濁っていたら交換（手順 B）。
   *[点検]* 判断基準が「光にかざして曇りが見えるか」で、経験に依存しない。◎

3. **ベルトを指で押して緩みを見る。** 動くようなら締め直す。
   *[点検]* 金具は工具不要（ラチェット式）。◎
   **宿題:** 締め具合の目安（例: 指 1 本が入る隙間）を刻印で示すこと。

4. **木の成長を見る。** ベルトが幹に食い込み始めていたら **1 段緩める**。
   *[点検]* 若い木なので毎回必ず見る。§D 参照。◎

5. **ベントの穴に汚れが詰まっていないか見る。** 詰まっていたら爪で払う。
   *[点検]* 工具ゼロ。◎

6. **箱を開けずに終える。** 開けるのは必要なときだけ。
   *[点検]* **開ける回数を減らすのが最大の防水策。** ◎

---

## B. ドームの交換（5 分・工具なし）

1. **ドームを反時計回りにひねって外す。**（回す向きは筐体に刻印してある）
   *[点検]* 工具ゼロ・嵌合式。◎ 刻印あり。◎

2. **座面（O リングの溝）を指で拭う。** 落ち葉のかけら・虫を取る。
   *[点検]* ◎

3. **O リングに指でシリコングリスを薄く塗る。**
   *[点検]* グリスは摩耗を減らし、印刷面の粗さを埋める（§4.9.4）。
   **宿題:** グリスの小袋を箱に括り付けておくこと。

4. **新しいドームを、爪と溝を合わせて押し込む。**
   *[点検]* 向きは既製品の嵌合で決まる（ポカヨケ）。◎

5. **ドームの縁が全周で座っているか、横から見て隙間を確かめる。**
   *[点検]* **段差で見える設計にする**という原則（§4.9 原則 4）。
   **宿題:** ドーム座に段差を彫って、浮きが影で見えるようにすること。

---

## C. 箱を開ける（電池交換・SD 交換・修理 / 10 分）

> **microSD は現地で抜かない運用**に決まったので、通常はこの手順に入らない。
> 開けるのは修理と部品交換のときだけ。

> **ベルトは外さない。** 蓋（鞍）は幹に巻いたベルトで押さえられていて、
> **箱の本体だけが手前に外れる。** 蝶ねじはベルトに掛からない位置にある
> （設計で保証してある。D-019）。

1. **箱の下側を向いたまま作業する。** 開口を上に向けない（雨・落ち葉が入る）。
   *[点検]* **宿題:** この注意を蓋に刻印すること。

2. **蝶ねじ 6 本を、側面の刻印の番号順（1 -> 2 -> ... -> 6）に緩める。**
   *[点検]* **6 本・大きい・順序が側面に刻印されている。**（原則 5 ◎）
   **原則 2「数を減らして大きく」には逆行している**が、パッキンの面圧が
   足りないため（D-019 / `docs/lid-fastening.md`）。番号は**中央 -> 対角 -> 対角**。

3. **蝶ねじは蓋から抜けない。** 落とさない。
   *[点検]* 捕捉式（原則 1）。◎ **2026-08-23 に設計した（D-020）。**
   蓋の内側の捕捉ポケットに、軸に付けたリテーナ（E 形止め輪 か 押しナット）が
   当たって止まる。**緩めきると先端は 1.3 mm しか出ないので、蓋を本体に平らに
   置いてから 1 本ずつ回し始めてよい**（6 本の先端を同時に穴へ入れる必要はない）。
   寸法の連鎖は `captive` チェックが毎回検証している。

4. **本体をまっすぐ引く。** ねじれない（キー溝が 1 箇所だけ深い）。
   *[点検]* ポカヨケ（原則 3）。**宿題:** キー溝が未設計。
   なお **M5 の 1 本と、中央の対が上下非対称**なので、蓋を逆向きには付けられない。

5. 作業する。**基板トレーを出すときは、指で 0.8 mm 持ち上げながら手前に引く。**
   両脇のタブを摘まむ。工具は要らない。戻すときは奥まで押し込むと「カチ」と落ちる。
   *[点検]* 工具ゼロ（原則 6）◎ / 逆向きには物理的に入らない（原則 3）◎
   **蓋を開けている間、トレーを落とさないためのクリック止めである**（D-021）。

6. **O リングに落ち葉・砂が付いていないか指でなぞる。** 付いていたら拭う。
   *[点検]* ◎

7. **蓋を戻し、番号順に 1 周「軽く」締めてから、もう 1 周「しっかり」締める。**
   *[点検]* 2 周締めはパッキンを均等に潰すため。1 本を一気に締め切ると
   そこだけ先に密着してパッキンが片側に寄る。**宿題:** これも刻印する。
   **力の目安: 1 本あたり 185 N**（手で締められる範囲。工具は要らない）。

8. **合わせ面の段差を全周見る。** 隙間が見えたら締め直す。
   *[点検]* **見て分かる**（原則 4）。**宿題:** 段差が未設計。
   計算上の浮きは 0.08 mm で目には見えないので、この目視は
   「浮きを測る」ためではなく **「締め忘れ・異物の噛み込みを見つける」**ため。

---

## D. 木を傷めないために（毎回）

設置先は**円周 15 〜 20 cm（直径 48 〜 64 mm）の若い木**である。
**ベルトは木の成長を締め付ける。** 放置すると幹に食い込み、형成層を殺して
その上が枯れる。

1. **毎回、ベルトと幹の間に指が入るか確かめる。** 入らなければ 1 段緩める。
2. **幅の広いベルト（25 mm 以上）を使う。** 細い紐は食い込みが早い。
3. **ベルトと幹の間にゴム板か古いホースを 1 枚挟む**と食い込みが遅くなる。
4. **1 年に 1 回は付け替える**（同じ位置で締め続けない）。
5. 幹に**釘・ねじを打たない。** 木材腐朽菌の入口になる。

*[点検]* いずれも工具なしでできる。◎
**宿題:** 「指が 1 本入る隙間」を鞍の脇に刻印すること。

---

## E. 未設計の宿題（この手順から出たもの）

| # | 宿題 | 出所 |
|---|---|---|
| ~~1~~ | ~~蝶ねじの**捕捉構造 x 6 本**~~ -> **2026-08-23 に設計（D-020 / `docs/captive-fasteners.md`）** | C-3 |
| 2 | 蓋の**キー溝**（ポカヨケ。1 箇所だけ深く） | C-4 |
| 3 | 合わせ面の**段差**（浮きが見える） | C-8 / B-5 |
| 4 | 刻印: 開ける向き / 「2 周締める」/ 「開口を上に向けない」（番号 1-6 と UP は実装済み） | C-1,2,7 |
| 5 | 刻印: ベルトの締め具合の目安 | A-3 / D-1 |
| 6 | シリコングリスの小袋を括り付ける場所 | B-3 |
| 7 | ドーム座の段差（座りが見える） | B-5 |

**1 以外はまだどの設計にも入っていない。** 蓋の設計に入るときにまとめて解く。
