OdaijinSamaX/wildlife-cam/firmware/esp32-box-b/CHANGES-20260825.md

# CHANGES 2026-08-25 — γ版 箱B ファーム（出発前に焼く4件）

対象: `esp32-fw/wildlife_box_b/wildlife_box_b.ino` と `config.h`
（直前の版は同じフォルダに `*.bak` として残っている。差分はそれと取る）

根拠: `観測ホール監査_20260823.md` の順位1〜3、および順位2の補足(b)。
背景: **8/26〜9/8 の13日間を無人連続運転にあてる。今日焼いたものが13日動き続ける。**

---

## 0. 先に読む2つ

### 0-1. 焼く順番（監査の指示どおり）

1. **先に `pump_live` で V_pump を実測して紙に書く。** それより先にこのファームを焼かない。
   減衰の合格帯（下の項目1）は、その実測を前提にした値を使う。
2. そのあと本ファーム。**鍵を貼ってから**焼く（項目4）。

### 0-2. 監査の指定を1点だけ変えた（読んでほしい）

監査 順位1 は「**4.0V** を切った時刻と **2.0V** を切った時刻の差を取れ」と書いている。
実装では **2.0V と 1.0V** にした。理由:

- その 4.0/2.0 は設計書の「V_pump = 5.9V」を前提にした数字。
- しかし `HANDOFF_20260822-23.md` §2/§3 で、**V_pump の実測は無負荷 3.13V / 実負荷 2.79V**
  と確定している。単段整流なのは意図的に正しく、直してはいけないことも同§に明記されている。
- つまり **4.0V は永久に来ない**。4.0/2.0 のまま実装すると、
  「健康な回路が一度も合格窓に入らない」という**いま直そうとしている穴を作り直す**ことになる。
- 比が 2:1 でありさえすれば `t_half = τ・ln2` は同じなので、実測ピーク 2.79V の下に収まる
  **2.0V / 1.0V** を採った。**分離比は監査の数字のまま（健康 66ms 対 故障 1386ms、21倍）**。
- 分圧後のピン電圧は 1.0V / 0.5V。この基板の ADC 下限 142mV から十分離れている。

閾値は `config.h` の `DECAY_TAU_HI_MV` / `DECAY_TAU_LO_MV` にあり、1か所で変えられる。
（`DECAY_TAU_HI_MV == DECAY_TAU_LO_MV * 2` は `static_assert` で守っている）

---

## 1. 減衰の「合格」を時定数 τ で測る（監査 順位1）

### 何を

- 閾値を跨いだ**時刻**ではなく、下り坂で **2.0V を切った時刻と 1.0V を切った時刻の差 `t_half`**
  を測るようにした。`t_half = τ・ln2` なので**ピーク電圧に依存しない**。
- 合格帯は**固定値にしない**。`config.h` の `DECAY_TAU_BASELINE_MS`（据付時に一度測った値）
  の **±40%**。初期値は **0 = 未設定**で、そのあいだは **ok とも urgent とも言わず `unknown`** を出す。
- 従来の「1300mV を割るまでの ms」も**そのまま印字を残した**（過去ログと比較できるように）。
- ハング時（core0 sampler 側）でも同じ `t_half` を出すようにした。

### なぜ

設計書 §5.2 の「1.3V を割るまで約1.5秒」が10倍の書き間違いで、健康な回路の実測は 67〜76ms。
合格窓 0.8〜3.0秒には**健康な回路が入らず、R_pd が外れた故障（約1.7秒）のほうが入る**。
毎晩 urgent が飛び、4日目には読まれなくなり、最後は検出器が手で無効化される。

### どう検証するか

焼いて `p`（強制ON 3秒）を押し、切れた直後の行を見る。**据付直後はこう出るのが正常**:

```
[減衰] 計測開始 V_pump=2790mV
[減衰] V_pump<1300mV まで 70 ms
[減衰tau] 通常OFF t_half=66 ms (2000→1000 mV) peak=2790 mV 判定=unknown(基準未設定)
          → 据付時の値です。config.h の DECAY_TAU_BASELINE_MS に 66 を書き写して焼き直してください。
```

- **`t_half` が 40〜90ms 付近** → 健康。その数字を `config.h` に書き写して焼き直す。
- **`t_half` が 1000ms 超** → R_pd かゲートの脚が外れている。**配線を見る**（焼き直しではない）。
- 書き写して焼き直したあとは、毎回こう出る:

```
[減衰tau] 通常OFF t_half=64 ms 判定=ok (基準 66 ms ±40% = 39〜92 ms) peak=2790 mV
```

- 故障したときはこう出る（13日間これを grep すればよい）:

```
[減衰tau] 通常OFF t_half=1386 ms 判定=NG(遅い: R_pd かゲート脚が外れた疑い) (基準 66 ms ±40% = 39〜92 ms) peak=2790 mV
```

- 測れなかったときも**必ず言う**（黙って走らないことが無いようにする）:

```
[減衰tau] 通常OFF t_half=unknown (3000 ms 以内に 1000 mV まで落ちず) peak=2790 mV
[減衰] 計測せず: ピークが 1800 mV で下限 2000 mV に届かず (通算 3 回)
```

**タイミング余裕**（実機が無いので机上で確認した）: R_pd が外れた最悪ケース（τ≈2s）でも、
ピーク 2.79V から 1.0V まで **約 2052ms**、無負荷 3.13V からでも **約 2282ms** で、
`DECAY_TIMEOUT_MS`(3000ms) の内側に収まる。だから故障側も `unknown` に落ちずに
ちゃんと `NG(遅い)` として出る。`DECAY_TIMEOUT_MS` は変えていない。

---

## 2. T_cap 45秒を「ランプの実態」に付け替えた（監査 順位2 — 唯一の安全側）

### 何を

- `lamp_hot_since_us` を新設。**PUMP 出力が連続 500ms 低かったときだけ**クリアする
  （`config.h` の `LAMP_COOL_US`）。45秒はこれを起点に数える。
- デューティ計上も同じ変数を基準にし、**10秒 × 60個のリング（120バイト）でずらして数える**。
  窓の一括ゼロクリアは廃止。上限 5分/600秒、解除は 4分30秒（ヒステリシス）。
- **ベンチ強制ON（`p`）にも同じ 45秒を効かせた。**
  45秒は「どの経路が点けたか」に依らずランプの実態に対する絶対上限であるべきなのと、
  **Pi 側に ON/OFF を撃つ道具が無い**ため（`ble_advertiser.py` に `--want` 相当が無い）、
  実機でこの直しを確かめられる唯一の道がこれだから。`p` は既定3秒なので通常運用には影響しない。

### なぜ

BLE の広告間隔は 100ms 固定、ランプが消えるには 150ms かかる。
**OFF → 100ms 後に ON を繰り返すと、ランプは一度も消えないのに 45秒の時計だけがゼロに戻り続ける。**
デューティ上限も、①ON 指令の時間しか数えない ②10分窓を丸ごとゼロクリアする、の二重で効かない。
結果、ランプが最長10分連続で点き、一晩分の IR 電池 83mAh を10分で使い切る。
さらに点滅中は MOSFET が線形領域を通過し、放熱器なし TO-220・密閉箱・周囲45℃で
監査 §15.2 R2 の「層1〜5 のどれでも防げない唯一の故障」を自分で作りかねない。

### どう検証するか

**2-A. 母艦で実施済み（実機不要・結果を下に貼る）**

`.ino` の `process_frame` / `service_state` / `lamp_track` を**そのまま呼ぶ**試験台を書いて、
監査が書いている交互点滅（OFF と ON を 100ms 交互）を 120 秒ぶん流した。

| | 旧版 (`.bak`) | 新版（今回） |
|---|---|---|
| ランプ実点灯の最大連続 | **119,899 ms**（試験全域。一度も切れない） | **45,399 ms**（45秒＋冷却待ち 0.4秒） |
| T_cap 到達 | **0回**（S5_LIT のまま） | **1回** → COOLDOWN へ |
| 実点灯の合計 / 120秒 | 60,000 ms | 29,900 ms |

正常な30秒イベントでは T_cap は**0回**、デューティ計上は約 30,500ms で、誤爆しないことも確認した。

**2-B. 実機で（ベンチだけで確認できる。Pi 不要）**

`p` を **2秒ごとに押し続ける**（`p` は3秒ぶんなので、押し続けるかぎりランプは消えない）。
45秒経つとこの行が出て、強制ONが打ち切られる:

```
[BENCH] 強制ON を T_cap 45秒(ランプ実点灯基準)で打ち切りました
[lamp] PUMP が連続 500ms Low → ランプは冷えたと判定(実点灯 45000 ms で終了)
```

押すのをやめて 0.5秒経つと `lamp_hot` は 0 に戻る（`s` で確認できる）。
**旧版では、何秒押し続けても打ち切られない。** そこが直った点。

**2-C. 13日間のログで見るところ**

10秒ごとの beaconB に、この1行が出るようにした。**これだけ grep すれば足りる**:

```
[beaconB] lamp_hot=0ms duty600=0/300000ms tcap_hit=0 duty_limit=0 tau{last=66ms,ok=41,ng=0,unknown=1} decay_skip=0
```

- `tcap_hit` が増えていたら、45秒上限が実際に働いた＝異常な点灯要求が来ている。
- `duty600` が 300000 に張り付き `(制限中)` が付いたら、点けすぎで抑えられている。
- `lamp_hot` が 45000 を超えることは**構造上ありえない**。超えていたらこの直しが効いていない。

正常イベントのときは:

```
[T_cap] ランプ実点灯が 45000 ms 連続 → 45秒上限で強制消灯(通算 1 回)
[deadman] PUMP OFF (T_cap 45秒到達(ランプ実点灯基準))
[duty] 直近600秒の実点灯 300000 ms が上限 300000 ms に到達 → 制限(通算 1 回)
[duty] 直近600秒の実点灯が 269000 ms まで低下 → 制限解除
```

---

## 3. シャントの「独立確認」（監査 順位3）

### 何を（正直に書く）

**ファーム側に外すべき行は無かった。** 確認したこと:

- `wildlife_box_b.ino` は `PIN_SHUNT`(GPIO35) を**一度も読んでいない**（`config.h` のピン定義だけ）。
- `shunt_mv_off` という識別子は、**この母艦のどこにも存在しない**
  （`~/gamma-fw-20260825/` 配下・`~/wildlife-cam-work/`・`~/wildlife-phase1/` を検索済み。
  ヒットしたのは監査文書そのものだけ）。
- 監査が言う `shunt_mv_off > 5mV` は **設計書 §9.4 の urgent 昇格条件**で、
  設計書の正本は `HANDOFF` によれば **Windows 側 OneDrive** にある。母艦からは触れない。

**→ この1行の削除は人間の作業として下の「やることリスト」に出した。**

### 代わりにファームでやったこと（穴を作り直させないため）

`config.h` の `PIN_SHUNT` の直下に、消してはいけない理由をコメントで固定した:

- IR 0.4〜0.6A × 0.1Ω = 全部で 40〜60mV。増幅器は無い。
- この基板の ADC 読み値の**下限は 142mV**（8/23 の対照試験: 内部45kΩで完全に 0V に落とした
  ピンが 8秒間 142mV から動かなかった）。
- **全点灯も完全消灯も同じ数字になり、しかも非ゼロ**なので、どんな判定も
  「電流は流れている」と読む＝**恒真式**。独立確認にならない。
- 将来 `shunt_mv_off > 5mV` のような AND 項を足すな、と明記した。

### どう検証するか

これは削除なので、**新しいシリアル出力は無い**。見るのは設計書側（下のリスト 4番）。
ファーム側は `grep -n PIN_SHUNT config.h` でコメントが入っていることだけ確認すればよい。

---

## 4. HMAC 鍵を「人間が貼るだけの空欄」にした（監査 順位2(b)）

### 何を

**鍵の値は決めていないし、どこにも書いていない。** 用意したのは仕組みだけ:

- `config.h` の先頭に `#define HMAC_KEY_IS_PLACEHOLDER 1` を置いた。
  - **1（今の状態）**: 従来どおり公開テスト鍵で動く。ただし
    **コンパイル時に `#warning`**、**起動時に★枠の警告**、**beaconB の毎行に警告**が出る。
  - **0**: 【本番鍵の空欄】のバイト列を使う。空のまま 0 にすると
    `static_assert` で**ビルドが止まる**（＝鍵無しのファームは焼けない）。
- 貼り方と「Pi 側と同時に替える」手順を `config.h` のコメントに書いた。
- **鍵の値はシリアルに一切出さない。** 長さも出さない。

母艦で両方の分岐を確認済み:

| 状態 | 結果 |
|---|---|
| `PLACEHOLDER 1`（今） | ビルド通る＋`#warning` が出る |
| `PLACEHOLDER 0` で空欄のまま | **ビルド失敗**: `HMAC_KEY が空か短すぎます: config.h の【本番鍵の空欄】に 16 バイト以上を貼ってください` |
| `PLACEHOLDER 0` で32バイト貼付 | ビルド通る・警告なし |

### なぜ

無人13日を走らせる前提で、この穴の発火条件のひとつが「鍵を持っている誰か」だから。
公開テスト鍵は Pi 側スクリプトの既定値として世に出ている。

### どう検証するか

**貼る前**（今の状態。この画面が出たら**まだ焼いてはいけない**）:

```
★★★★★★★★★★★★★★★★★★★★★★★★★★★★★★★★★★★★★★★★★★
★ 警告: HMAC 鍵が config.h の公開テスト鍵のままです。
★ 無人運用(8/26〜9/8)に投入してはいけません。
★ config.h の【本番鍵の空欄】に鍵を貼り、HMAC_KEY_IS_PLACEHOLDER を 0 に。
★ ※Pi 側 ble_advertiser.py の --key と必ず同時に替えること。
★★★★★★★★★★★★★★★★★★★★★★★★★★★★★★★★★★★★★★★★★★
```

**貼ったあと**（この1行になっていること。★枠が消えていること）:

```
[鍵] HMAC は本番鍵で動作します(値は表示しません)。Pi 側と一致していることを確認してください。
```

**鍵が Pi と食い違っていないこと**は、これで判定する:

- 正: `[CMD] ON 受理 seq=... → 鮮度更新` が出る。`bad_mac` が増えない。
- 誤: `[破棄] HMAC 不一致 (bad_mac=N) seq=...` が**増え続ける**。
  → **片方だけ元に戻さないこと。** 両方を同じ鍵で焼き直す。
- 13日ログでは beaconA の `fault{bad_mac=0,...}` が 0 のままであること。

---

## 5. 母艦でやった検証と、やれていないこと

### やった

- **構文・型・printf 書式の検査**: ESP-IDF / Arduino のスタブを書いて `g++ -Wall -Wextra -Wformat=2`
  を通した（**エラー0**。残る警告は意図した `#warning` と、ホストの `int64_t` が `long` である
  ことに由来する `%lld` の指摘だけ。ESP32 では `int64_t` は `long long` なので `%lld` が正しい。
  既存コードも同じ書き方）。
- **挙動試験**: 実物の `process_frame` / `service_state` / `lamp_track` を直接呼ぶ試験台で、
  正常30秒イベントと交互点滅攻撃を新旧両方で流した（上の 2-A の表）。
- **鍵スロットの3分岐**（上の表）。

### やれていない（実機が要る）

- **`arduino-cli` はこの母艦に無い**（`arduino-cli: command not found`）。
  `HANDOFF` の「開発環境」節のとおり、ビルド環境は **Windows 側**にある。
  **本物のコンパイルは Windows で1回通してから焼くこと。** 上の検査は構文・型・書式までで、
  ESP-IDF の実ヘッダとの整合（マクロ名や関数シグネチャ）までは見ていない。
- τ の実測値。ピーク 2.79V も 8/23 の実測を引いているだけで、今日の実測ではない。
- ハング時の `t_half`（`h` コマンドで確認できるが、`BENCH_MODE 1` のときだけ）。

### 触っていないもの（意図的）

- **20kHz のソフトビットバング**と、判定・ポンプ駆動を同一ループに閉じ込める不変条件。
  LEDC / RMT / タイマ ISR は使っていない。`lamp_track` も guardian の同一ループ内から呼んでいる。
- **`D_clamp` のアノード**（3V3 に移していないし、文書でも触れていない）。
- `DECAY_THRESH_MV`(1300) / `DECAY_TIMEOUT_MS`(3000) / `VPUMP_MIN_FOR_DECAY_MV`(2000) / `TCAP_US`(45秒)
  / `COOLDOWN_US`(60秒) の値そのもの。
- SENSE 断線検出、状態機械の遷移、受理規約（§4.3）、scan の3点指定。
- 監査の順位5・6・7・8（サンプラ回数カウンタ、6.2V の常識チェック、`stale` の扱い、ORPHAN 条件）。
  **今回の4件には入っていないので実装していない。**

---

## 6. 人間がやることリスト

### A. 焼く前（順番どおりに）

1. **`pump_live` で V_pump を実測して紙に書く。** SENSE の3本（GND / 25 / 34）は
   ブレッドボードの列に頼らず、ボードを抜いて裏のヘッダにメスジャンパを直挿しする。
   **この測定より先に本ファームを焼かない**（監査 順位4）。
2. **鍵を作る。** 例: `openssl rand -hex 32`。
   **この値をログ・チャット・この文書・コミットに残さない。**
3. **`config.h` に貼る。**
   - 【本番鍵の空欄】に `0x..,` のカンマ区切りで貼る（32バイト推奨）。
   - `#define HMAC_KEY_IS_PLACEHOLDER 1` を **0** にする。
   - 貼り忘れるとビルドが止まる（それが正しい動作）。
4. **Pi 側を同じ鍵にする。** `ble_advertiser.py` の `--key` に同じバイト列になる表現で渡す。
   **片方だけ替えると全フレームが `bad_mac` で捨てられ、ESP32 は鮮度切れで消灯したまま13日過ぎる。**

### B. 焼く

Windows 側で（`HANDOFF` の手順そのまま。非ASCIIパス回避の複製が要る）:

```powershell
$src   = "C:\Users\iwhay\OneDrive\Desktop\遠隔カメラシステム\γ版\esp32-fw\wildlife_box_b"
$build = "<scratchpad>\esp32build\wildlife_box_b"
Copy-Item "$src\*" $build -Force
$exe = "C:\Program Files\Arduino CLI\arduino-cli.exe"
& $exe compile --fqbn esp32:esp32:esp32 $build      # ★まずここが通ること
& $exe upload -p COM8 --fqbn esp32:esp32:esp32 $build
```

**この母艦のファイルを OneDrive 側へコピーするのを忘れないこと**（正本は OneDrive 側）。
なお `HANDOFF` の落とし穴1のとおり、`.ino` を再生成すると `config.h` が戻る事故が起きている。
**今回は `config.h` に鍵が入るので、上書き事故に特に注意する。**

### C. 焼いた直後（10分で終わる）

1. 起動画面に **★枠の鍵警告が出ていないこと**を確認（出ていたら鍵が入っていない）。
2. `s` を押して `lamp_hot=0 ms (ランプは冷えている)` と `tau: ... 基準=0 ms` を確認。
3. `p` を押して切れ際の `[減衰tau] ... 判定=unknown(基準未設定)` の **`t_half` の数字を控える**。
4. **その数字を `config.h` の `DECAY_TAU_BASELINE_MS` に書き写して、もう一度焼く。**
   （ここまでやらないと13日間ずっと `unknown` のままで、合否が出ない）
5. `p` を2秒ごとに45秒押し続けて、`[BENCH] 強制ON を T_cap 45秒...で打ち切りました` が出ることを確認。
6. Pi を上げて `[CMD] ON 受理` が出ること、`bad_mac` が増えないことを確認。

### D. ファームではない作業（監査 順位3・出発前の1行）

**設計書 §9.4 の urgent 昇格条件から `shunt_mv_off > 5mV` の AND 項を消す。**
設計書は Windows 側 OneDrive にあり、母艦からは触れなかった。
`142 > 5` は常に真なので、この項は独立確認ではなく恒真式で、
警報疲れを防ぐために書かれた条件が警報疲れを製造している。
消して、**カメラ側の3回連続＋移動中央値だけ**で判定する。

あわせて（監査 順位1「同時にやること」。今回はファームだけを触ったので未着手）:
設計書の「1.5秒」を全部「0.15秒」に、§5.5 の窓、Phase 2-2 と Phase 8 の合格条件6 を書き換える。

### E. 出発までに間に合わなければ諦めてよいもの

- `DECAY_TAU_BASELINE_MS` を埋めないまま出る場合: 減衰は毎回 `unknown` で出続ける。
  **`ok` にはならないが `urgent` にもならない**設計にしてある。13日ぶんの `t_half` の数字は
  ログに残るので、帰国後にまとめて読める。**そこは壊れない。**
- ただし **鍵（A-2〜A-4）だけは飛ばせない。** 公開テスト鍵のまま13日は走らせない。
