OdaijinSamaX/wildlife-cam/(commit log)

2026-05-15 Initial commit: Wildlife Camera System
    Raspberry Pi 5 + HC-SR501 PIR sensor + PiCamera3 による野生動物検知・録画・アップロードシステム。
2026-05-20 v0.0.3 parent-child wifi relay
2026-07-28 Fix Pi Zero 2 W recording hang and harden field reliability
    Recording silently hung on Pi Zero 2 W: create_video_configuration()
    allocates a full-sensor RAW stream by default (2304x1296, ~6MB/frame x
    buffer_count), which exhausts the 424MB of physical RAM and deadlocks
    picamera2/libcamera in futex wait. No Python exception, no OOM kill --
    the process just stops while holding the camera, so even rpicam-still
    then fails with "Device or resource busy".
    camera.py:
    - Disable the RAW stream (raw=None). This alone makes both 720p and
    1080p record reliably; measured 1080p/8Mbps at 8.1MB per 10s clip.
    - Make resolution/bitrate/buffers configurable via CAMERA_* env vars.
    - Never return a path to a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
    [camera.py, runtime.py]
2026-07-28 Make the trap recover unattended after a power cycle
    The unit file assumed a supervised machine: it waited on network.target,
    which is satisfied as soon as configuration starts rather than when a
    route exists, and it only restarted on failure, so a clean exit left the
    trap silent until someone noticed.
    - Wait on network-online.target, NetworkManager and ModemManager so the
    app does not start before LTE can come up. Kept as Wants, since the
    app already holds safely when the link is down.
    - Restart=always with RestartSec=10, and StartLimitIntervalSec=0 to
    disable the restart rate limit. In the field a service that systemd
    gives up on is a trap that stays dark, and nobody is there to r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
2026-07-29 Light the IR illuminator while recording
    夜間の撮影で 850nm 投光器を録画中だけ点灯させる。これまで照明制御は
    コードに存在せず、暗所では何も写らなかった。
    - illuminator.py: GPIO18 で 2SK4017 のゲートを叩き、12V 側のローサイドを
    断続する。lit() コンテキストで、例外経路でも必ず消灯する(点きっぱなしで
    電池を空にしないため)。GPIO が掴めない場合は照明だけ諦めて録画は続ける
    - runtime.py: standalone / child の録画を lit() で囲む。終了時に close()
    - 投光器側に光量センサーがあるため、昼夜の判定はソフトに持たない
    - 録画の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
2026-07-30 Add camera-side IR measurement bench
    肉眼では IR の効きも点灯タイミングも判定できないので、Pi のカメラ自身に
    測らせる。⚠️輝度平均では判定できない — 自動露出が明るさを打ち消すため、
    IR を点けると平均輝度はむしろ下がる(実測 130->64)。露出時間が主指標で、
    IR が足した光量の分だけ露出が短くなる(実測 27,255us->240us = 113倍)。
    - 白飛び画素率で「投光器がカメラの画角に入っている」を自動検出する。
    画角に入るとカメラが光源に露出を合わせ被写体が真っ黒になる。2026-07-30 の
    昼の測定で実際に踏んだ失敗モ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
2026-08-07 Harden field network: fix LTE-only DNS + self-healing watchdog
    Root cause of the 2026-08-06 outage: lte-his had ipv4/ipv6.ignore-auto-dns=true
    with no dns= fallback, so on LTE-only (no WiFi) /etc/resolv.conf had zero
    nameservers. IP worked but nothing resolved -- Web UI, uploads, apt all died.
    - setup-network.sh (idempotent): restore lte-his DNS (ignore-auto-dns=no +
    public 1.1.1.1/8.8.8.8, v6 too), keep 600/900 metrics; persistent journald
    via 99- drop-in (overrides RPi's 40-rpi-volatile-storage.conf); logrotate;
    install+enable wildlife-netwatch.timer.
    - wildlife-netwatch.sh: 60s watchdog, composite L3/DNS/L7 health, staged
    escalation (log -> lte up -> wlan0 demote+penalty -> modem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
2026-08-07 Guarantee an IPv4 resolver in resolv.conf's top-3 + detect v4-DNS death
    Follow-up to the field-network hardening. glibc's resolver only reads the
    first 3 nameservers, and NetworkManager orders IPv6 before IPv4 at equal
    dns-priority -- so on LTE-only the top-3 could be all IPv6. If LTE comes up
    IPv4-only (no v6 bearer / 3G fallback), those 3 die and it's the 2026-08-06
    outage all over again.
    - setup-network.sh: set lte-his ipv4.dns-priority=10 (< ipv6 200) so IPv4
    resolvers always lead; collapse v6 DNS to a single entry (ipv6.ignore-auto-dns
    yes) as belt-and-suspenders. Positive priority only -- negative would make
    the connection's DNS exclusive and drop home 192.168.68.50 entirely; in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
2026-08-07 Harden field camera recovery and storage
2026-08-07 Cap LTE upload volume instead of throttling capture
    Field test on LTE sent 271MB in 23 minutes (PIR false-triggers uploading a
    full-quality clip every 20-30s). Per the owner's decision, do NOT limit
    capture (missing a clip defeats the purpose of counting trapped animals);
    cap only the *upload* volume and let overflow accumulate on the SD card.
    - field_limits.py: rolling 1-hour upload budget (WILDLIFE_UPLOAD_BUDGET_MB_PER_HOUR,
    default 250), counted only on LTE (default route wwan0, mirroring net-status.sh);
    WiFi is unmetered. State persisted under /var/lib/wildlife-cam so the budget
    survives restarts. When exceeded, uploads pause and recording continues.
    Cooldown (default 0) and bur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
    [field_limits.py, runtime.py, video_storage.py]
2026-08-08 Document the 2-core box-to-box cable and the GPIO pin map
    現地(ver.β)の箱間ケーブルを 10芯の3芯並列GNDから2芯(GPIO18/GND)へ
    簡素化した。12V・約0.5Aのループは IR 箱の中で閉じるため、ケーブルに
    流れるのはゲート駆動とGND基準だけで実質0mA。GNDを並列にする必要はない。
    あわせて、ヘッダから取る5本(PIR=2/9/11番, IR=12/14番)を一覧にした。
    PIR の GND が物理9番で IR の GND(14番)とは別系統である点が、これまで
    どこにも明記されていなかった。
    100Ω と 10kΩ を IR 箱側に置く理由(断線時にゲートがプルダウンされたまま
    になり IR が消灯側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
2026-08-08 Use two cables between the boxes instead of picking cores
    本人の意図は「10芯ケーブルを2本使い、1本まるごとを1つの線に充てる」
    だった(芯を選び分ける手間をなくすための割り切り)。前のコミットは
    「1本から2芯を選ぶ」と誤読していたので書き直す。
    ケーブル① = IR制御(GPIO18/物理12番)、ケーブル② = IR GND(物理14番)。
    電気的には変わらない(0.5Aのループは IR 箱の中で閉じており、ケーブルに
    流れるのはゲート駆動とGND基準だけ)が、行きと帰りが別ケーブルになるので
    ループ面積が増える。結束バンドで束ねる指示を足した。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
2026-08-08 fix(field): decouple arm-check from detection loop + harden LTE v6 blackhole
    2026-08-08 に wildlife-zero で「PIR は正常なのに Motion detected が出ない」を
    現地診断した結果への恒久対策。真因は v6-over-LTE ブラックホール + is_armed()
    キャッシュ永久失効 + 検知ループの毎周ブロッキング HTTP の 3 段連鎖。
    - arm 状態を背景スレッド(arm_monitor.ArmStateMonitor)で定期取得し、PIR 待機
    ループはメモリ値のみ読む。通信断=保留(作動しない)は monitor 側で担保。
    runtime.run_standalone / run_child の should_continue を非ブロッキング化。
    - uploader.WorkerUploader: キャッシュ格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
    [arm_monitor.py, runtime.py, sensor.py, uploader.py]
2026-08-08 feat(survey): add site-survey protocol + one-shot RF/upload survey script
    設置候補地が「使えるか」を現地で1分で判定するための調査ツール一式を追加。
    - scripts/site-survey.sh: WiFi電波(nmcli)→LTE電波(mmcli)→疎通(generate_204)→
    実サイズ相当の上りアップロード実測(curl, 既定3MB/公開サーバ・秘密情報なし)を
    連続実行し、最小BOM可/LTE単独(要注意)/設置不可 を自動判定して記録用1行を出力。
    既存 net-status.sh / field_limits.py と判定規則(default route dev, 250MB/h)を整合。
    - docs/site-survey-protocol.md: 非プログラマ向けA4 1枚チェックリスト。判定マトリ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
2026-08-08 feat(camera): pin lens focus to hyperfocal-ish position for far traps
    Camera Module 3 (NoIR/標準) は起動時に AF を回さず、LensPosition 無指定だと
    レンズが既定位置(約1m相当)に留まり、罠の実距離(3〜5m以遠)で常に甘くなる。
    初期化時に AfMode=Manual + LensPosition を明示して焦点を固定する。
    - WILDLIFE_LENS_POSITION(ジオプター・既定0.5≒焦点2m)で調整可能
    - 適用値を起動時 INFO ログに出力(現地デバッグ用)
    - AF 非搭載カメラ(v2/HQ)では例外を警告のみで握り、録画は継続
    - 根拠(CM3 f=4.74mm/F1.8, 過焦点H≒4m)を camera.py と README に明記
    - CHANGELOG 更新。実機画質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
2026-08-08 Add all-carrier signal scan via EG25-G QSCAN
    現地で「どのキャリアの電波が届くか」を SIM の契約網に依存せず 1 コマンドで
    判定できる scripts/carrier-scan.sh を追加する。AT+QSCAN=3 で周囲の全 PLMN を
    RSRP/RSRQ 付きで列挙し、MCC/MNC→キャリア名・EARFCN→バンドに変換して
    docomo/au/SoftBank/楽天 ごとに最良セルを ◎/○/△/× で評価する。
    安全ガード: 実行前に LTE 断の確認プロンプト（--yes で省略）、
    wildlife-netwatch.timer と ModemManager を一時停止し、trap で必ず復帰・
    lte-his 再接続を待ってから結果表示。QSCAN 非対応 firmware では AT+COPS=? に
    自動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
2026-08-09 fix(field): carrier-scan を実機確定手順の v2 に書き換え
    実機 wildlife-zero(EG25GGBR07A08M2G) で判明した事実に合わせて全面書き換え:
    - AT ポート特定を ModemManager 停止「前」に移動（mmcli は MM 停止中は空。
    停止後に探す v1 の実装は必ず失敗した）。mmcli の (at) ポートから引き、
    実在候補の先頭 /dev/ttyUSB2 をフォールバック既定にした。
    - AT+QSCAN は本機 firmware で非対応と確定 → 主経路を COPS 方式へ変更。
    AT+QSCAN=? が OK を返したときだけ試す opportunistic 扱いに降格。
    - 登録中セルの電波は AT+QENG="servingcell" から RSRP/RSRQ/SINR/band を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
2026-08-09 feat(field): carrier-scan v2 に --json モードを追加
    survey-api の /api/fullscan から非同期起動して結果を機械可読で受け取れるよう、
    --json フラグを追加。stdout には最終 JSON だけを出し、人間向けログ (say) は
    stderr へ逃がす。--json は無人前提なので --yes を暗黙で有効化する。
    JSON 形: {site, time, method, serving:{carrier,rsrp_dbm,rsrq_db,sinr,band,...}|null,
    carriers_present:[{carrier,label,present,act,rsrp_dbm,band,rating}]}。
    render_report と同じ集計を JSON 化する render_report_json を追加し、--self-test に
    JSON の構造・パース(python3)チェックを追加 (全38件パス)。
    Co-Authore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
2026-08-09 feat(survey-api): localhost 測定エンジン (status/quick/fullscan) を追加
    電波調査ページ用に、Python 標準ライブラリのみの HTTP API を追加。127.0.0.1:18085
    固定で待受け、公開は tailscale serve の /api マウント経由のみを想定する。
    - GET /api/status 生存確認 {ok,host,time,battery_mode?}
    - POST /api/quick ~30-60s の無断線測定: mmcli --signal-get で RSRP/RSRQ/SNR、
    mmcli -m で在圏オペレータ、nmcli で WiFi 上位5件、curl で上りプローブ
    - POST /api/fullscan carrier-scan.sh v2 を --json で非同期起動 (LTE 数分断)。
    多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
2026-08-09 feat(survey-api): 電波調査ページに Pi 測定セクションを追加
    現行のスマホ手動測定ページを services/survey-api/static/index.html に取り込み、
    Pi のモデム/WiFi で測って自動転記できるよう発展させた。
    - 最上部に「Pi 測定」: [⚡クイック測定] [📡全キャリアスキャン] ボタン。fetch("/api/...")
    の結果を画面表示し、RSRP/在圏網/上りMbps を記録フォームへ自動転記
    - CSV 列を拡張: rsrp_dbm, rsrq_db, snr_db, carriers_present, upload_mbps_pi
    - スマホ手動欄 (キャリア/見えた網/アンテナ本数/手動Mbps) は「Pi が手元に無い下見用」の
    折りたたみ (details)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
2026-08-09 chore(deploy): survey-api を配備導線に載せ、serve 手順を明記
    - deploy.sh の一括 rsync に services/ (survey-api) が含まれることを明示し、初回の
    systemd 常駐化 + tailscale serve 公開手順を Next steps に追加 (.venv も除外)
    - README の道具箱 (toolbox) に survey-api への 1 行ポインタを追加
    - tailscale serve 設定 (/ 静的 + /api → 127.0.0.1:18085) と sudoers は
    services/survey-api/README.md に記載。setup-network.sh には入れない (手動1回で永続)
2026-08-09 fix(field): carrier-scan の AT 対話バグ修正 + モデム救急処置
    実機で決定的に再現していた「【NG】 AT ポートに応答がありません」を修正。
    ポート特定(MM 停止前)と後片付けは正常なので、AT 対話層のみを実機の
    成功レシピに合わせて書き換えた。
    原因と対処:
    - A: 応答の頭取りこぼし → reader(cat) 先行方式へ。cat を先に起動し、
    settle(0.5s) してからコマンド書き込み、応答を後読みする。
    - B(主因): stty の非ゼロ終了を fatal 扱いしていた。EG25 は stty が
    "unable to perform all requested operations" を返すが対話は成立する。
    `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
2026-08-11 feat: 録画時間・撮影間隔をWeb UIから遠隔設定可能に + 8/11 15:30以降の動画を全件表示
    - Worker: trap-config/<id>.json (R2) に record_seconds/cooldown_seconds を保持。
    GET /traps/:id (デバイス) と GET /traps (Web) に合成、PATCH で更新。
    Supabase スキーマ変更なしで完結させるための設計判断。
    - Pi: arm ポーリング応答から設定を取り込み、検知ループが毎周適用。
    優先順位 = サーバ設定 > .env (WILDLIFE_RECORD_SECONDS / WILDLIFE_MOTION_COOLDOWN_SEC) > 既定。
    通信断時は直近取得値がメモリに残るため設定は生き続ける。
    - Web: 罠カードに録画設定フォーム (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
2026-08-11 fix(web): スマホ幅で罠設定フォームが画面外へ溢れる問題を修正
    スマホ幅 (≤680px) では .trap-card が flex-direction: column になり、
    .trap-config の flex-basis: 100% が高さ基準と解釈されて、フォームが
    横の新しい列へ折り返され画面外に溢れていた (375px 幅で再現・修正後を確認)。
    width: 100% に変更し、row/column 両方向で全幅になるようにした。
    併せて入力欄を 16px にし、iOS Safari のフォーカス時強制ズームを抑止。
2026-08-11 feat: PIR持続判定(motion_sustain_seconds)を遠隔設定チェーンに追加
    5分おきの誤検知(クールダウン明け即検知=連続刺激)への対策として、
    「HIGHがN秒継続して初めて検知」のNを設定可能にする。
    サーバ設定(R2 trap-config) > env WILDLIFE_MOTION_SUSTAIN_SEC > 既定1.0秒。
    範囲 0.5〜10.0秒(小数可)。Web UIの罠カードに「検知持続(秒)」欄を追加。
    注意: HC-SR501のHモードでは出力HIGHが「動体+Tx(遅延つまみ)」の間続くため、
    Txが持続判定より長いと一瞬の動きでも判定を通る。Txを最小に絞るのが前提。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
2026-08-12 feat: エージェントチャット (Web=読み取り専用の状態確認窓口)
    NPO協力者にも公開できる「カメラに聞く」画面を追加。設計判断=Webは完全読み取り
    専用(操作系APIは存在させない)・操作はTelegramのみ。
    - Supabase: agent_messages テーブル+RLS (質問投稿は本人名義のみ・author_emailは
    JWTに固定・未回答3件/人の上限・user 2000字/agent 4000字)
    - Worker: デバイス側2エンドポイント (GET /agent/inbox, POST /agent/replies)。
    返信は pending->answered の条件付きPATCH(CAS)を先行させ二重回答を構造的に拒否
    - Web: チャットUI (降順取得+反転・送信の楽観反映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
2026-08-13 feat: 透明送信ゲート+SD容量ガード (WIP: 実クリップ検証前)
    - motion_screen.py: 決定論的スクリーニング(フレーム差分+ブロブ+版管理閾値)
    全クリップに judgment.json / 迷ったら送信 / held動画は削除しない
    - storage_guard.py: 80%でTelegram回収要請・95%で録画停止(ユーザー決定)
    - 罠カードにSD使用率表示 (heartbeat同乗 + traps.storage_pct列)
    - docs/transparent-gate.md: 設計思想と追跡可能性の担保
    - 既定は無効 (WILDLIFE_SCREEN_ENABLED=1 で有効化)
2026-08-13 fix(screen): 正味移動を始点→終点の変位で測る + 弱い動体をnoneにしない
    合成クリップ9本での検証 (T1) で3件の不一致が出た。原因はいずれも実在の欠陥。
    1. 正味移動の実装がドキュメントと食い違っていた (最重要)
    docs は「往復運動では伸びない正味移動」と規定しているが、実装は軌跡上の
    任意2点間の最大距離を測っていた。差分ブロブの重心は物体の前縁と後縁を
    交互に立てるため、その場で揺れるだけでも物体幅ぶんの値が出る。結果、
    大きく揺れる藪 (10.0%) がゆっくり横切る動物 (15.8%) と分離でき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
    [motion_screen.py]
2026-08-13 fix: セルフレビュー(T2)で見つけた統合部の不具合
    1. worker: storage_pct が最初から最後まで死んでいた
    parseStoragePct() を定義しただけで呼んでおらず、handleTrapState は
    upsertTrapHeartbeat(env, trapId, isArmed) と3引数で呼んでいた。Pi が送る
    x-storage-pct ヘッダは誰にも読まれず、罠カードのSD使用率は永遠に空。
    ヘッダを parseStoragePct 経由で渡すよう結線。
    2. runtime: SD満杯(95%)で停止中に滞留クリップの送信まで止めていた
    送信に成功したクリップは削除されるので、送信は「回収に行かずに空きを
    取り戻せる唯一の自動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
    [motion_screen.py, runtime.py, storage_guard.py, uploader.py]
2026-08-13 test: 送信ゲートの合成クリップ回帰テストを追加
    閾値やルールを変えたときに判定の変化を必ず見えるようにする。
    クリップ生成の落とし穴 (drawbox の t は時刻でなく線の太さ / 揺れを
    2Hz にすると解析 2fps とエイリアスする) を docstring に残した。
    どちらも「テストが偶然通ってしまう」種類の罠で、実際に踏んだもの。
    python3 tools/verify_screen_gate.py # 10/10 一致で exit 0
2026-08-13 chore: バージョン規約の制定とCHANGELOGの世代別再構成
    α=0.1.x / β=0.2.x / γ=0.3.x (全体を0.xに留め研究開発版であることを明示。
    v1.0.0は複数台実運用移管の日のために予約)。
    βの現地知見(屋久島 8/9-12)を v0.2.0 として集約、γ開幕分は unreleased 節に記載。
2026-08-13 docs: READMEを現行運用値と実装済み機能に同期
    - バージョン規約(α/β/γ=0.1/0.2/0.3.x)の節を追加
    - envサンプルを屋久島実運用値(2Mbps/バッファ2/30s/300s/3.0s)に更新
    - 遠隔設定チェーン・3秒ゲート・エージェントチャットの節を追加
    - Roadmapにγの透明送信ゲートと種同定第2段を反映
2026-08-22 chore: enclosure-lab の器を作成
2026-08-22 feat: 筐体設計ハーネス MVP と wildlife-cam 向け設計 2 種
    書いた形を自動で見て・測って・数字で突き返すループを作る。
    harness/
    cli / design / geom / build / render / report と 7 つのチェック
    (manifold, wall, bbox, interference, clearance, overhang, openings)
    すべてのチェックは PASS/FAIL だけでなく実測値と「何を見逃すか」を返す。
    レンダは VTK の EGL オフスクリーンを採用し、numpy の Z バッファによる
    ソフトウェアラスタライザを予備に持つ。断面は実際にブーリアンで切って描く。
    parts/
    Pi Zero 2 W / Camera Module 3 / HC-SR501 / EG25-G / IR 投光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
    [cam_module3.py]
2026-08-22 fix: O リング溝が基準ピンの根元を削っていた不具合と、それを捕まえる layout チェック
    ## 不具合
    fit_coupon 初版で、O リング溝の帯（中心 30,-17 / r 13.65..16.35）が基準ピン
    φ10.0（中心 26,3 / r 5）の根元を 0.95 mm 削っていた。中心間距離 20.396 mm に
    対し、必要なのは 16.35 + 5.00 = 21.35 mm。
    report の overhang WARN（z=8 / span 0.95 mm / 3.31 mm2）はこの症状だった。
    ## 1. 形状の修正
    台座を 100x70 から 120x90 に広げ、全フィーチャを配置し直した。
    100x70 のままでは、6 段のフィーチャ列と φ33 の O リング帯を、すべての
    フィーチャ間に 1.6 mm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
    [fit_coupon.py, pir_bezel.py]
2026-08-22 fix(parts): eg25g を SORACOM Onyx (SC-QGLC4-C1) として作り直す
    実物の型番が判明した。mini-PCIe カードではなく **USB ドングル**だった。
    中の無線モジュールが Quectel EG25-G。以前の前提（mini-PCIe full size
    30 x 51 x 4.5 / u.FL x 2）は全て誤りだったので破棄する。
    parts/eg25g.py -> parts/soracom_onyx.py
    ## メーカー公称（DIM_SOURCE = "estimated" -> "datasheet"）
    外形 95 x 36 x 13 mm / 36 g
    USB-A オスのプラグ直付け（ケーブル無し）
    電源 USB のみ 4.2 - 6 V
    動作温度 -20 - +60 degC
    外部アンテナ端子 CRC9 x 2（MAIN / DIV）※ u.FL x 2 という想定は誤りだった
    SIM スロ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
    [soracom_onyx.py]
2026-08-22 fix: HC-SR501 実測反映と PIR 封止方式の作り直し、OTG ケーブルを追加
    ## parts/hcsr501.py — 推定を全て破棄し実測に差し替え
    DIM_SOURCE: "estimated" -> "measured:2026-08-22"
    PCB 32.8 x 24.4 x 1.4 / DOME_DIA 23.0 / DOME_H 14.4（基板表面から頂点）
    SKIRT_H 3.3 / BACK_COMP_H 8.0（導出: 23.8 - 14.4 - 1.4）/ 全高 23.8
    HOLE_DIA 2.2 と HOLE_PITCH 28.5 は **誤差の可能性あり** と注記（UNCERTAIN）
    ドーム形状も作り直した。φ23.0 の円筒スカート 3.3 mm + 高さ 11.1 mm の球冠。
    球半径 11.507 mm で z=3.3 の面内半径が 11.500 となりスカートと接線連続になる。
    ## 最重要 — O リン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
    [hcsr501.py, otg_cable.py, pir_bezel.py]
2026-08-22 feat: 実測から起こした寸法補正テーブルと fit_coupon v2
    2026-08-22 に fit_coupon v1 を P1S / ASA / 0.4 mm ノズル / 平置きで印刷し、
    実物を測った結果をハーネスに焼き付ける。
    ## 1. 補正テーブル harness/fit.py
    設計は **狙い寸法**（印刷後にこうなってほしい寸法）だけを書き、図面寸法への
    変換はテーブルが一箇所で行う。設計者が式の中で足し引きするのは禁止。
    wall 全域 +0.00 実測 4 点とも誤差ゼロ
    hole φ8.0 以上 +0.30 実測 4 点とも誤差 -0.30 で一定。刻みも一致
    hole φ2.0 〜 5.0 +0.25 暫定（誤差 -0.10 〜 -0.30 とば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
2026-08-22 feat: 内部レイアウト比較検討 3 案と Onyx 実測の反映
    ## Onyx の実測反映（DIM_SOURCE: datasheet -> measured:2026-08-22）
    BODY_L 77.5 / USB プラグ突出 11.9 / 全長 89.4（旧公称 95 とは 5.6 食い違う）
    BODY_W 35.8（公称 36 と一致）/ BODY_H 13.2
    後端 20.8 mm の区間で厚みが 9.3 に落ちる面取り -> 脇に部品を寄せられる
    **ASSEMBLED_WITH_OTG_L = 115.0**（実測）を追加。OTG の USB-A メスを挿した
    組立状態の全長で、**箱の中を貫く曲がらない実長**。単体の 89.4 ではなくこちらが
    レイアウトを支配する。115.0 = 89.4 + 35.0 - 差し込み代 9.4 で辻褄が合う。
    外部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
2026-08-22 feat: レンダに内蔵部品を描く + Camera Module 3 の実測反映
    ## 1. レンダに COMPONENTS を描く（ハーネスの一般機能）
    レイアウト検討のレンダに外殻しか写っておらず、断面を切っても中が空洞だった。
    部品が見えないレンダは「人が見て案を選ぶ」目的を果たさない。
    views/*.png 印刷される部品だけ（不透明）— 従来どおり
    views/assy_*.png **新規**。外殻を半透明 (0.22) にして内蔵部品を色分けで重ねる
    iso / front / top / right の 4 視点
    views/section_*.png **外殻も内蔵部品も同じ面で切る**ようにした。部品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
2026-08-22 feat: 視野チェック / ドーム窓 / 現地 UX 原則 / 取り付け評価やり直し
    ## 1. fov チェック（ハーネスの一般機能）
    設計が VIEW_CONES を宣言すると、印刷部品と内蔵部品の両方を視野円錐と
    ブーリアン積して食い込みを実測する。体積と**角度**（半角から何度内側まで
    入っているか）で出す。レンズ諸元は要検証なのでパラメータ化した。
    導出: 焦点距離 4.74 / センサ対角 7.4 -> 対角半角 37.98 度（対角 75.95）。
    **帰結: 真っ直ぐな筒は L < 1.281 r でしか成立しない。** 細長い筒は作れず、
    短くて末広がりの形にしかならない。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
2026-08-22 feat: カメラユニット本体と蓋の実設計（案D を起こす）
    ## 造形高さの制約について（先に確認）
    背面の開口を上にして刷るので、**造形時の Z は箱の「奥行き」= 50 mm** になる。
    設計上の高さ 198 mm は造形時には XY 平面に寝るので、効く上限はベッドの 256 mm。
    閉じた箱は天井ができて刷れないため、この姿勢に選択の余地はない。
    案D の 229 mm も同じで、造形姿勢適用後の Z は 31.7 mm と出る。
    つまり **229 mm は造形の上限としては効いていない**。それでも高さは
    229 -> 198 mm に減らした（受風面積 -13%）。造形のためで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
2026-08-22 docs: 引き継ぎ文書と、会話にしか無かった前提の明文化
    ## docs/NEXT-SESSION.md 新設
    **会話の記憶が無いエージェントが最初に読む文書。** 読む順序・今日の到達点・
    明日やることを優先順に・未設計 9 件・外部から来る予定の情報をまとめた。
    最優先の懸案として、**蓋の締結点が四隅 4 本で足りるか**を最初に置いた。
    人間が図を見て指摘した内容で、一次見積りを添えてある:
    締結点の間隔 174 mm / O リング線圧 4 N/mm / 蓋の断面 I = 28,128 mm4
    -> 中央たわみ 0.85 mm。O リング φ2.0 の潰し代 0.50 mm を食い尽くす
    -> 中央に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
2026-08-23 feat: 蓋の締結を 6 点に。パッキン面圧の seal チェックを新設
    人間から「長辺 198 mm を四隅 4 本だけで押さえて、辺の中央でパッキンの面圧が
    足りるのか」という指摘が出た。**指摘は正しかった。**
    ## 数値評価（harness/seal.py・新設）
    蓋を梁、パッキンを非線形の弾性床（Gent の硬度→弾性率 + Lindley の O リング
    圧縮式）とみなして解く。断面二次モーメントは build() した形状を薄くスライスして
    実測するので、設計側に数字を書かせない。
    四隅 4 点 : 中央の浮き 0.233 mm -> 最小圧縮率 13.3%（静的シールの下限 15% 割れ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
2026-08-23 feat: 蝶ねじ 6 本を捕捉式に。captive チェックを新設
    現地で保守するのは機械に強くない人で、屋久島の林床で落としたねじは落ち葉の中で
    二度と見つからない（AGENTS.md §4.9 原則 1）。蓋を外したとき蝶ねじが蓋に残る構造を
    6 点すべてに入れた。docs/field-procedure.md C-3 の宿題（未設計だった）。
    ## 採った形
    蓋のシール面側に捕捉ポケット（φ9.8 / φ11.8 x 深さ 10.5）を彫り、蝶ボルト M4 x 30
    （1 本だけ M5 x 30）の軸に平たいリテーナを 1 個付ける。リテーナは E 形止め輪
    （JIS B 2805 呼び 4 / 呼び 5）でも、同じ外径に収まる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
2026-08-23 feat: 基板トレー。アリ溝が蓋の柱と両立しないと分かったので方式ごと作り直した
    docs/enclosure-body.md §9 の未設計 1 番。指示は「レール区間 z 128〜194 を通る
    蓋の柱 2 対を避けた形にすること」だったが、**素直にやるとレール方式そのものが
    落ちる**ことが分かった。
    ## アリ溝が成立しない理由（2 つあり、どちらも「レールを短くする」では解けない）
    1. **柱が Pi の通り道を塞ぐ。** 柱が x 26.9〜35.1 を占めるので内側に残る幅は
    53.8 mm。Pi Zero 2 W は 65 mm あるので**柱の z を通り抜けられない。**
    アリ溝は端から差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
2026-08-23 chore: 公開リポジトリとしての体裁を整える
    - config/.env を追跡対象から外し、.gitignore に明示（実ファイルは各機に残す）
    - README に「この repo の位置づけ」と「現場導入の実績」を追加
    - wildlife-loop / cam / log / trap / fly の構成を明示
    - 屋久島でのβ版稼働と有償納品、現状がプロトタイプであることを記載
    実行コード・systemd unit・deploy.sh には触れていない。
2026-08-23 chore: MIT License を追加
    README の License 節が「license file はありません」のままだったので実体を追加。
    ソフトウェアと hardware/ 以下の設計データの双方に適用する。
2026-08-23 docs: 公開版から内部の引き継ぎ文書への参照を外す
2026-08-23 feat: 筐体設計 (enclosure-lab) を hardware/enclosure へ統合
    enclosure-lab の設計・検証ハーネスを subtree で取り込み、履歴も保持した。
    CadQuery で形を書き、レンダと13種の数値チェックを通してから造形する仕組み。
    - README に「ハードウェアと筐体」の節と Repository map の項目を追加
    - deploy.sh の rsync に --exclude="hardware/" を追加（Pi へ CAD を送らない）
    公開範囲から除外したもの:
    第三者製品の測定・複製に関する資料 (CSI レスキュー基板) は、
    統合元を git-filter-repo で除去してから取り込んでいる。全履歴に含まれない。
    内部の引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
2026-08-23 chore: 表記を wildlife-cam に統一
    README のタイトルと導入文、deploy.sh のコメント、systemd unit の
    Description を命名体系 (wildlife-loop / wildlife-cam / wildlife-log) に揃えた。
    Description は systemctl status の表示にしか使われず、スクリプトは unit の
    ファイル名で引いているため動作に影響しない。
    runtime.py のログ文字列は、8/26 からの連続稼働試験前に実行コードへ
    触れない方針を維持するため、9/8 以降に回す。
2026-08-23 fix(readme): 筐体の数値チェックの数を実数に直す
    13 種類と書いていたが実際は 12 種類 (bbox / captive / clearance / fit /
    fov / interference / layout / manifold / openings / overhang / seal / wall)。
    「など」で濁していた部分も全12種を列挙する形にした。
2026-08-25 feat(enclosure): レスキュー装着後の Pi に合わせて箱を 84 -> 88 にし、トレーを作り直した（移植）
    **これは移植であって新規設計ではない。** 元は enclosure-lab の `2eaa2b1`
    （`task/tray-rescue-fit`）。筐体設計は 2026-08-23 に本リポジトリの
    `hardware/enclosure/` へ統合されたが、その後も指示が enclosure-lab に
    投げられ続けたため、この 1 本が取り残されていた。
    ## 外形が変わる（D-022）
    CSI コネクタのラッチ修理用ブラケット（双葉数理技術「Camera Connector Rescue」）
    を付けた Pi の実測が入り、前提が 3 つ崩れた。
    剛体幅 65.0 -> 76.9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
2026-08-25 feat(firmware): γ版 箱間リンクの実体（ESP32/Pi/母艦）を repo に入れる
    13日無人運転(8/26〜9/8)で実際に動いているものが、それぞれ 1 箇所にしか
    無かった。ESP32 ファームは母艦と Windows のみ、Pi の常駐化一式は Pi の
    SD のみ、母艦のロガー一式は母艦のホームのみ。どれか 1 つ飛ぶと再構築でき
    ないので、3 台ぶんまとめて firmware/ に取り込む。
    置き場所: このリンクは ESP32・Pi・母艦の 3 台が揃って初めて 1 つの系に
    なるので、hardware/enclosure/ と同じ「自己完結した 1 サブプロジェクト」の
    流儀で firmware/ にまとめた（repo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
